LJ-STAND/Design-2017/Drawings & Pinouts/KS_T_3.5.jpg

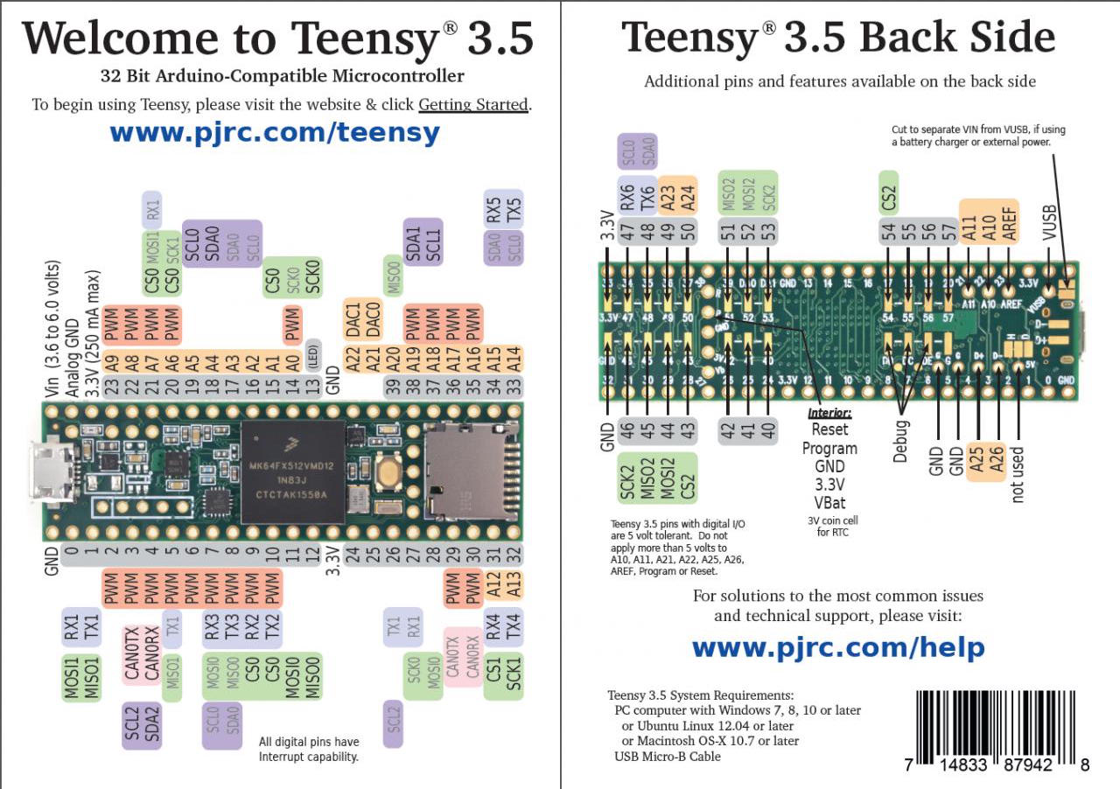
Drawings & Pinouts/KS_T_3.5.jpg
