LJ-STAND/Design-2017/Models/Pixy/Renderings/pixy_back.JPG

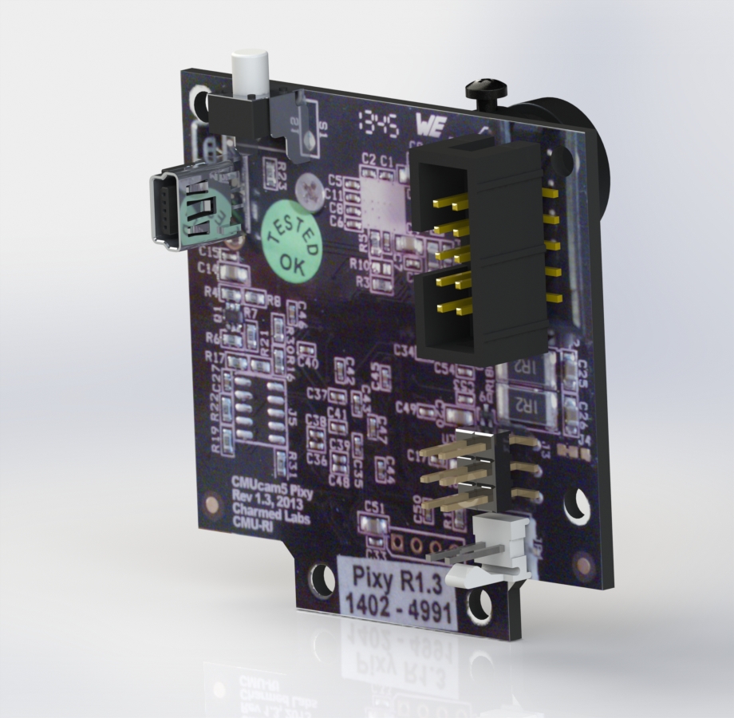
Models/Pixy/Renderings/pixy_back.JPG
