LJ-STAND/Design-2017/Drawings & Pinouts/Toshiba Motor Controller Circuit.PNG

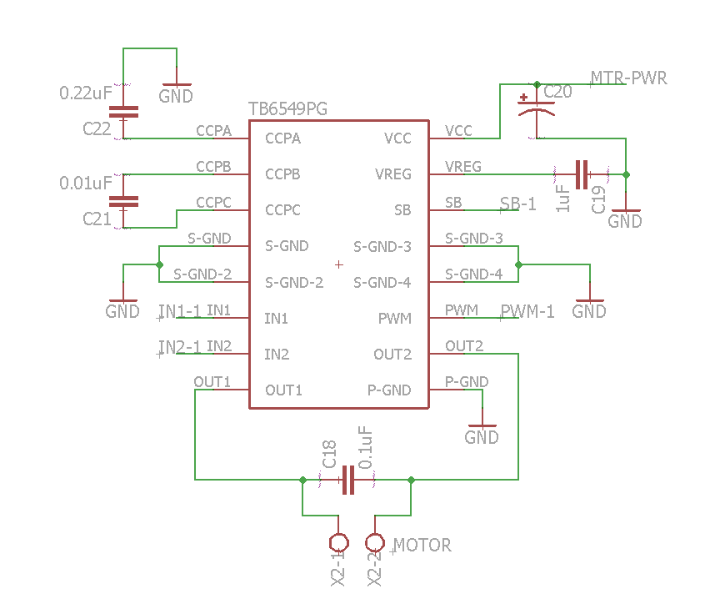
Drawings & Pinouts/Toshiba Motor Controller Circuit.PNG
