LJ-STAND/Design-2017/Models/Pixy/Renderings/pixy_front.JPG

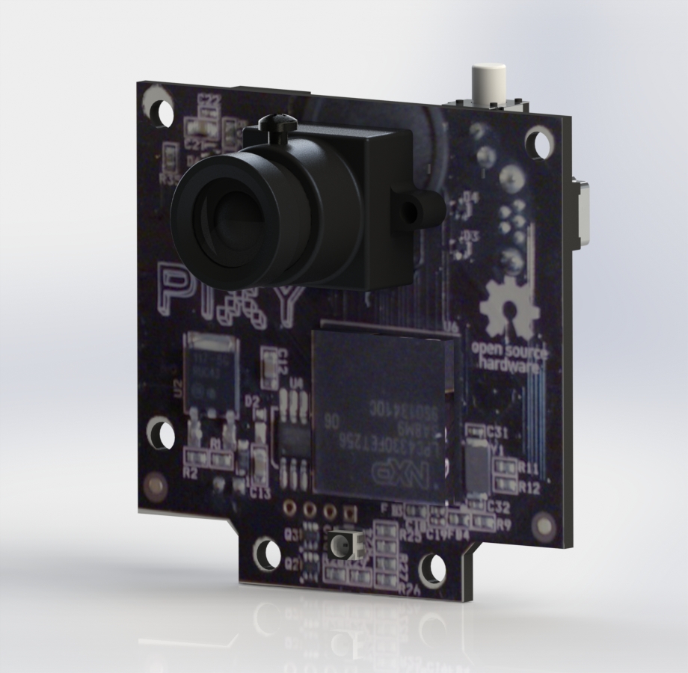
Models/Pixy/Renderings/pixy_front.JPG
