LJ-STAND/Design-2017/Robot top.png

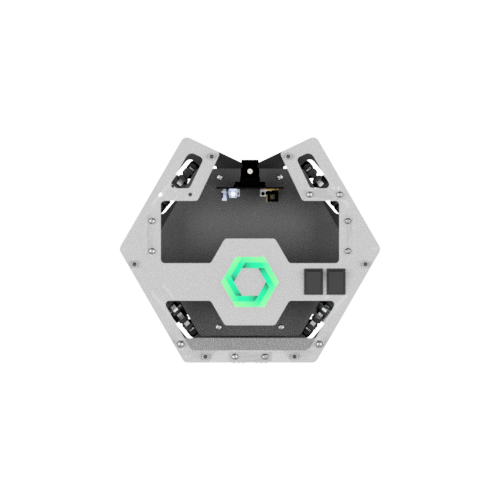
Robot top.png
