LJ-STAND/Design-2017/Models/Common/Imported Components/maxon_PN_0_1/maxon_PN_0_1.htm

Autodesk Inventor Translation Report | Friday, 11 November 2016 ( 8:32 PM)
Source File: | C:\Users\James Yelland\git\LJ-STAND\Design\Models\Common\maxon_PN_0_1.stp
Translator Type: | STEP | Sending System: | ACIS
Author: | maxon motor ag | Translation Time: | 00:00:02
Options
Import Type: | N/A
Entity Types to Import: | Solids, Surfaces, Wires, Points
Import into Repair Environment: | Yes
Import Assembly as Single Part: | No
Create Surfaces As: | Single Composite Feature
Check Parts during Load: | No
Auto Stitch: | No
Enable Advanced Healing: | N/A
+/- | Name | Inventor File | Status
[ ] | maxon_PN_0_1.iam | C:\Users\James Yelland\git\LJ-STAND\Design\Models\Common\Imported Components\maxon_PN_0_1\maxon_PN_0_1.iam | Successful
[ ] | maxon_PN_0_1.ipt | C:\Users\James Yelland\git\LJ-STAND\Design\Models\Common\Imported Components\maxon_PN_0_1\maxon_PN_0_1.ipt | Successful
[ ] | maxon_PN_0_2.ipt | C:\Users\James Yelland\git\LJ-STAND\Design\Models\Common\Imported Components\maxon_PN_0_1\maxon_PN_0_2.ipt | Successful
[ ] | maxon_PN_0_3.ipt | C:\Users\James Yelland\git\LJ-STAND\Design\Models\Common\Imported Components\maxon_PN_0_1\maxon_PN_0_3.ipt | Successful
[ ] | maxon_PN_0_3_1.ipt | C:\Users\James Yelland\git\LJ-STAND\Design\Models\Common\Imported Components\maxon_PN_0_1\maxon_PN_0_3_1.ipt | Successful
[ ] | maxon_PN_0_4.ipt | C:\Users\James Yelland\git\LJ-STAND\Design\Models\Common\Imported Components\maxon_PN_0_1\maxon_PN_0_4.ipt | Successful
[ ] | maxon_PN_0_5.ipt | C:\Users\James Yelland\git\LJ-STAND\Design\Models\Common\Imported Components\maxon_PN_0_1\maxon_PN_0_5.ipt | Successful
[ ] | maxon_PN_0_5_1.ipt | C:\Users\James Yelland\git\LJ-STAND\Design\Models\Common\Imported Components\maxon_PN_0_1\maxon_PN_0_5_1.ipt | Successful
[ ] | maxon_PN_0_5_2.ipt | C:\Users\James Yelland\git\LJ-STAND\Design\Models\Common\Imported Components\maxon_PN_0_1\maxon_PN_0_5_2.ipt | Successful
[ ] | maxon_PN_0_6.ipt | C:\Users\James Yelland\git\LJ-STAND\Design\Models\Common\Imported Components\maxon_PN_0_1\maxon_PN_0_6.ipt | Successful
[ ] | maxon_PN_0.ipt | C:\Users\James Yelland\git\LJ-STAND\Design\Models\Common\Imported Components\maxon_PN_0_1\maxon_PN_0.ipt | Successful
