LJ-STAND/Design-2017/Models/Pixy/pixy/Imported Components/Pixy(CMUcam5)/Pixy(CMUcam5).htm

Autodesk Inventor Translation Report | Friday, 11 November 2016 ( 9:08 PM)
Source File: | C:\Users\James Yelland\git\LJ-STAND\Design\Models\Pixy\pixy\Pixy(CMUcam5).STEP
Translator Type: | STEP | Sending System: | SolidWorks 2013
Author: |  | Translation Time: | 00:00:02
Options
Import Type: | N/A
Entity Types to Import: | Solids, Surfaces, Wires, Points
Import into Repair Environment: | Yes
Import Assembly as Single Part: | No
Create Surfaces As: | Single Composite Feature
Check Parts during Load: | No
Auto Stitch: | No
Enable Advanced Healing: | N/A
+/- | Name | Inventor File | Status
[ ] | Pixy(CMUcam5).iam | C:\Users\James Yelland\git\LJ-STAND\Design\Models\Pixy\pixy\Imported Components\Pixy(CMUcam5)\Pixy(CMUcam5).iam | Successful
[ ] | Pixy_board_rev1.3.ipt | C:\Users\James Yelland\git\LJ-STAND\Design\Models\Pixy\pixy\Imported Components\Pixy(CMUcam5)\Pixy_board_rev1.3.ipt | Successful
[ ] | header_2x5ways.ipt | C:\Users\James Yelland\git\LJ-STAND\Design\Models\Pixy\pixy\Imported Components\Pixy(CMUcam5)\header_2x5ways.ipt | Successful
[+] [-] | mini_usb_b_vertical_connector_D‚faut.ipt | C:\Users\James Yelland\git\LJ-STAND\Design\Models\Pixy\pixy\Imported Components\Pixy(CMUcam5)\mini_usb_b_vertical_connector_D‚faut.ipt | Warning
Severity | Entity Id | Message
Warning | 39828 | Some Surfaces have been simplified
[ ] | RGB_led_CMS_STD.ipt | C:\Users\James Yelland\git\LJ-STAND\Design\Models\Pixy\pixy\Imported Components\Pixy(CMUcam5)\RGB_led_CMS_STD.ipt | Successful
[ ] | switch-FSMRA6JH_D‚faut.ipt | C:\Users\James Yelland\git\LJ-STAND\Design\Models\Pixy\pixy\Imported Components\Pixy(CMUcam5)\switch-FSMRA6JH_D‚faut.ipt | Successful
[ ] | M12_lens_holder_D‚faut.ipt | C:\Users\James Yelland\git\LJ-STAND\Design\Models\Pixy\pixy\Imported Components\Pixy(CMUcam5)\M12_lens_holder_D‚faut.ipt | Successful
[ ] | header3x2_D‚faut.ipt | C:\Users\James Yelland\git\LJ-STAND\Design\Models\Pixy\pixy\Imported Components\Pixy(CMUcam5)\header3x2_D‚faut.ipt | Successful
[ ] | header_MTA-100_2pins_D‚faut.ipt | C:\Users\James Yelland\git\LJ-STAND\Design\Models\Pixy\pixy\Imported Components\Pixy(CMUcam5)\header_MTA-100_2pins_D‚faut.ipt | Successful
[ ] | pixy_lens_D‚faut.ipt | C:\Users\James Yelland\git\LJ-STAND\Design\Models\Pixy\pixy\Imported Components\Pixy(CMUcam5)\pixy_lens_D‚faut.ipt | Successful
[ ] | pan head cross recess screw_iso_ISO 7045 - M2 x 4 - Z --- 4C.ipt | C:\Users\James Yelland\git\LJ-STAND\Design\Models\Pixy\pixy\Imported Components\Pixy(CMUcam5)\pan head cross recess screw_iso_ISO 7045 - M2 x 4 - Z --- 4C.ipt | Successful
