LJ-STAND/Design-2017/PCBs/Main.dxf

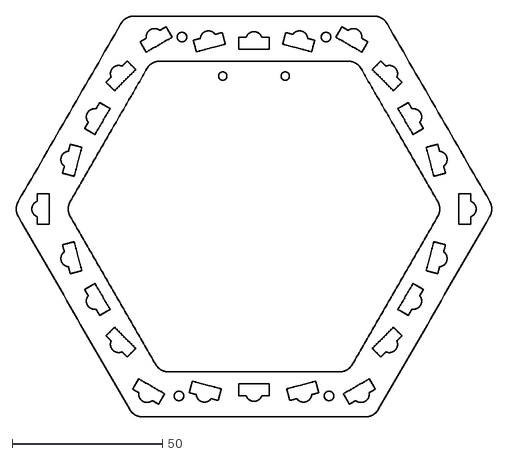
[picture p6: CAD file, 2016-11-10]
PCBs/Main.dxf
158.5 x 133.6
