LJ-STAND/Design-2017/3D Printing/Ball Capture Zone Cover.stl

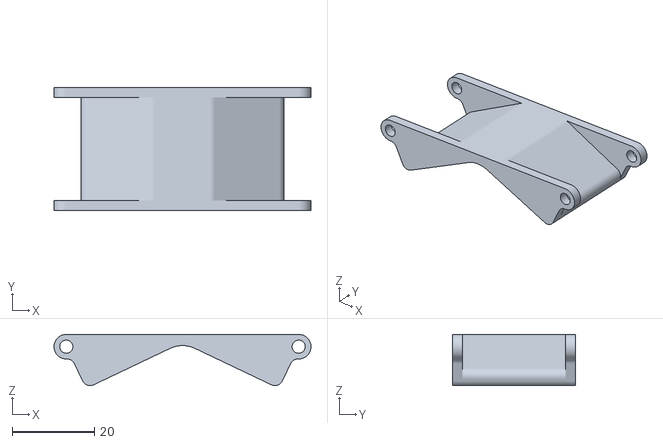
[picture p7: CAD file, 2017-07-10]
3D Printing/Ball Capture Zone Cover.stl
62.5 x 30.0 x 12.5
