LJ-STAND/Design-2017/Models/Common/maxon_PN_0_1.stp

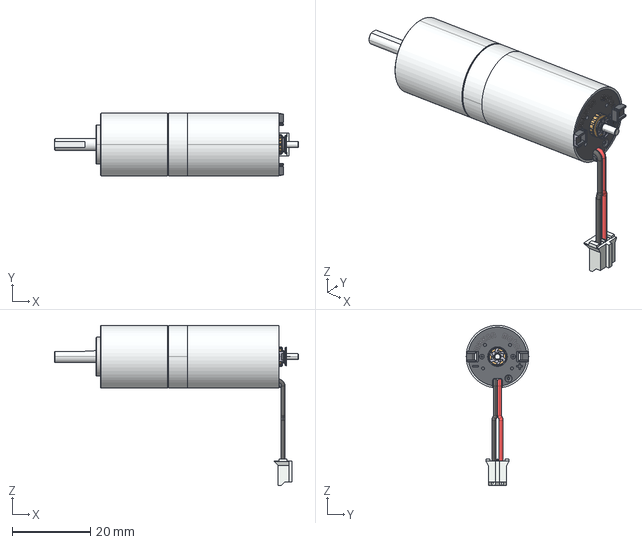
[picture p8: CAD file, 2016-10-30]
Models/Common/maxon_PN_0_1.stp
62.4 x 16.0 x 41.0 mm
