LJ-STAND/Design-2017/Models/Pixy/pixy/M12_lens_holder.SLDPRT

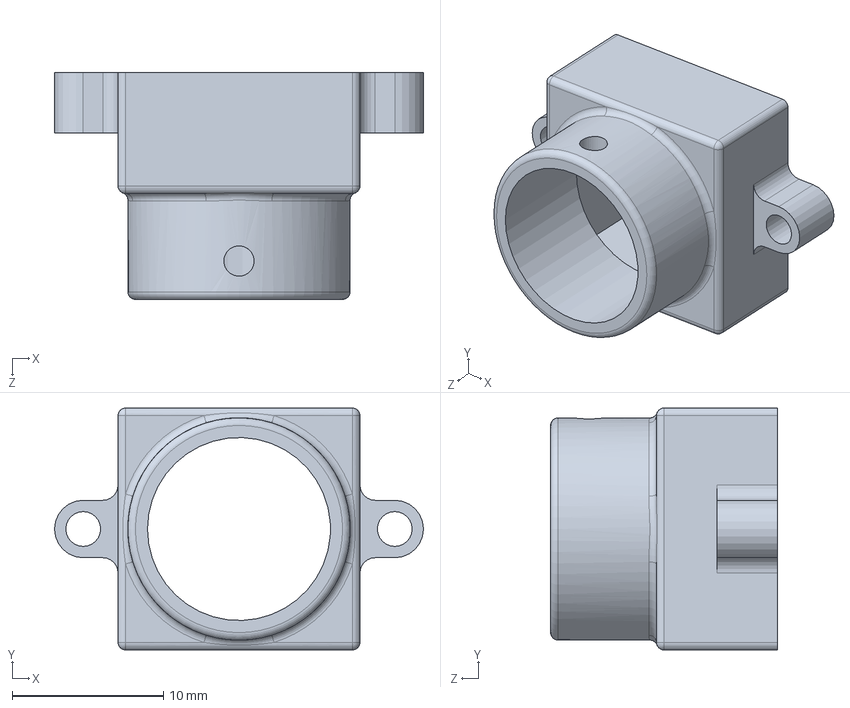
[picture p9: CAD file, 2016-09-21]
Models/Pixy/pixy/M12_lens_holder.SLDPRT
24.4 x 16.0 x 15.0 mm
