LJ-STAND/Design-2017/3D Printing/TSOP Cover Ring.stl

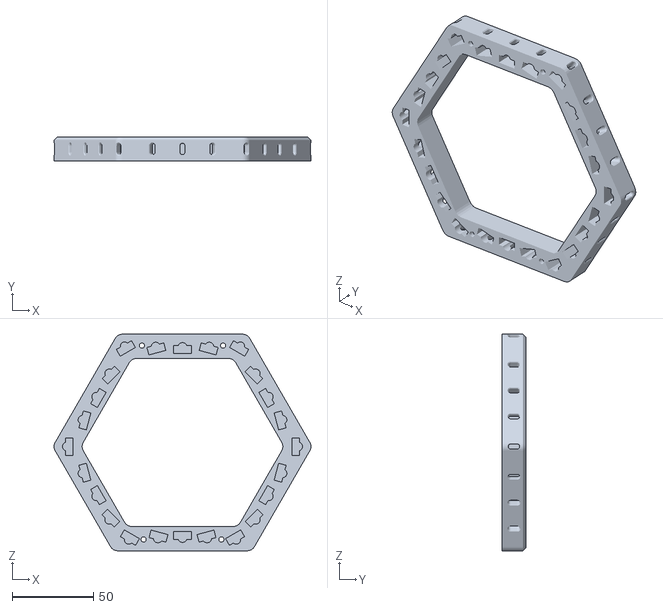
[picture p10: CAD file, 2017-03-27]
3D Printing/TSOP Cover Ring.stl
158.5 x 15.0 x 133.6
