LJ-STAND/Design-2017/Models/Pixy/pixy/RGB_led_CMS.SLDPRT

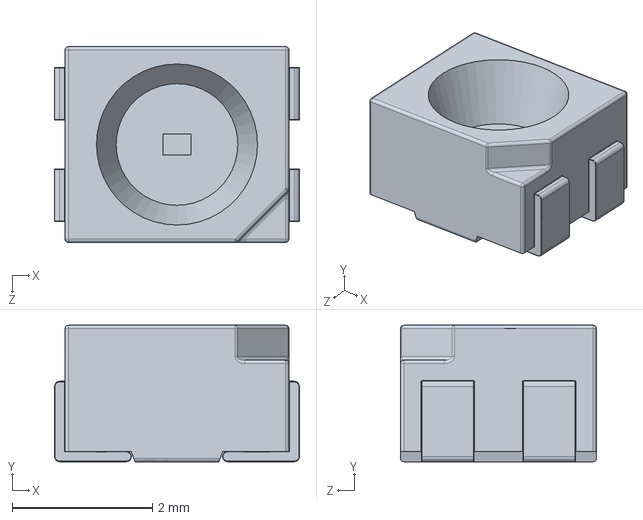
[picture p11: CAD file, 2016-09-21]
Models/Pixy/pixy/RGB_led_CMS.SLDPRT
3.50 x 1.95 x 2.80 mm
