LJ-STAND/Design-2017/PCBs/Kicker.dxf

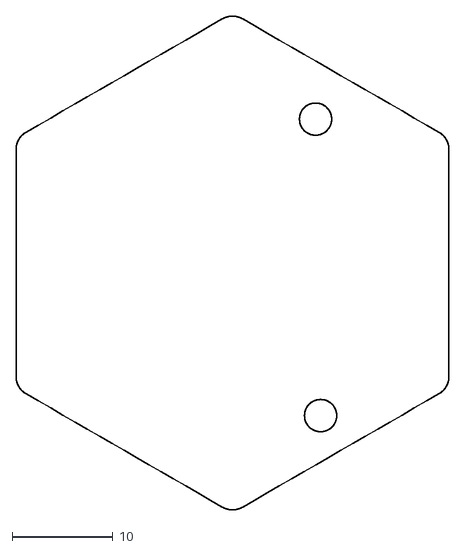
[picture p12: CAD file, 2017-03-21]
PCBs/Kicker.dxf
43.0 x 49.0
