LJ-STAND/Design-2017/3D Printing/Sonar Mount.stl

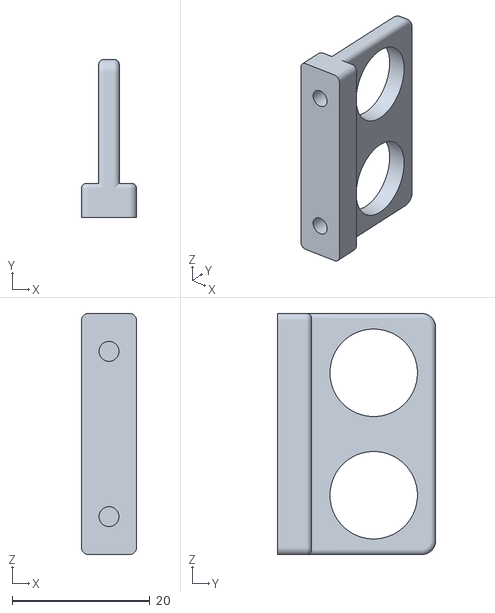
[picture p13: CAD file, 2016-11-30]
3D Printing/Sonar Mount.stl
8.00 x 23.0 x 35.0
