LJ-STAND/Design-2017/Models/Pixy/pixy/pixy_lens.SLDPRT

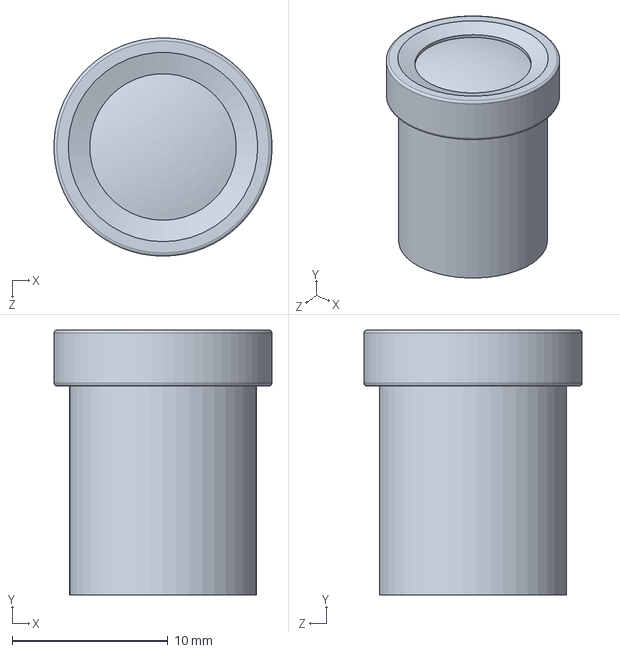
[picture p14: CAD file, 2016-09-21]
Models/Pixy/pixy/pixy_lens.SLDPRT
14.0 x 17.0 x 14.0 mm
