LJ-STAND/Design-2017/PCBs/Light.dxf

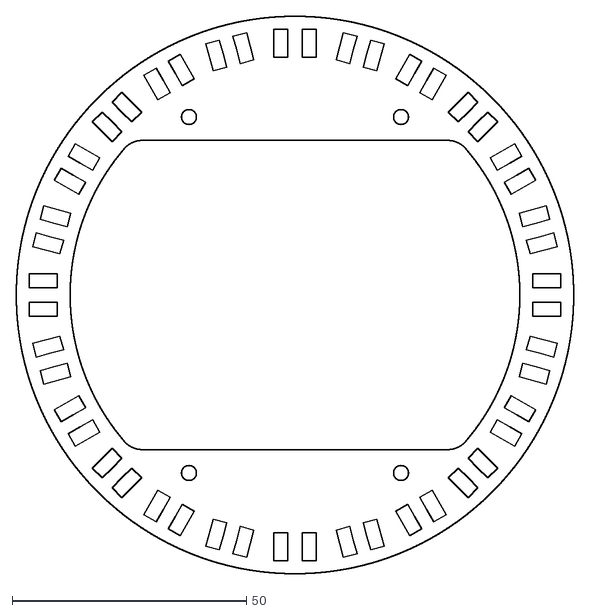
[picture p15: CAD file, 2016-11-10]
PCBs/Light.dxf
119.0 x 119.0
