LJ-STAND/Design-2017/Plates/Wheel/Roller.dxf

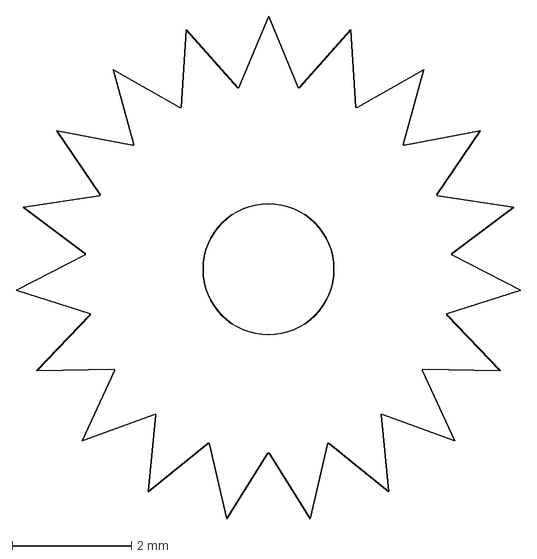
[picture p16: CAD file, 2016-12-01]
Plates/Wheel/Roller.dxf
8.47 x 8.44 mm
