LJ-STAND/Design-2017/Models/Pixy/pixy/header3x2.SLDPRT

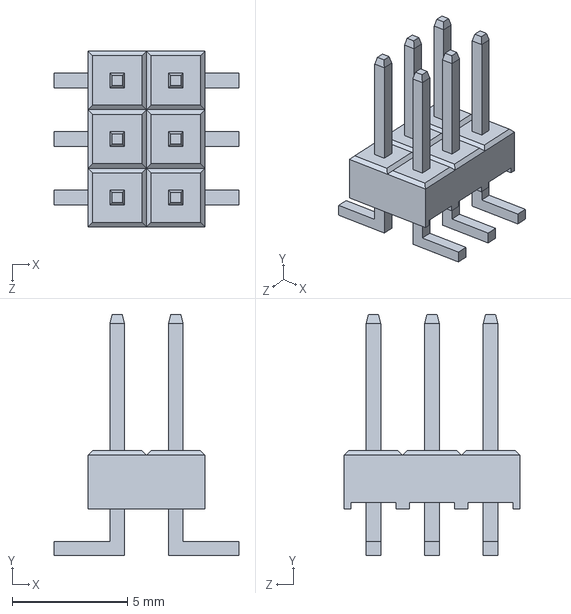
[picture p17: CAD file, 2016-09-21]
Models/Pixy/pixy/header3x2.SLDPRT
8.00 x 10.4 x 7.62 mm
