LJ-STAND/Design-2017/Models/Pixy/pixy/Pixy_board.SLDPRT

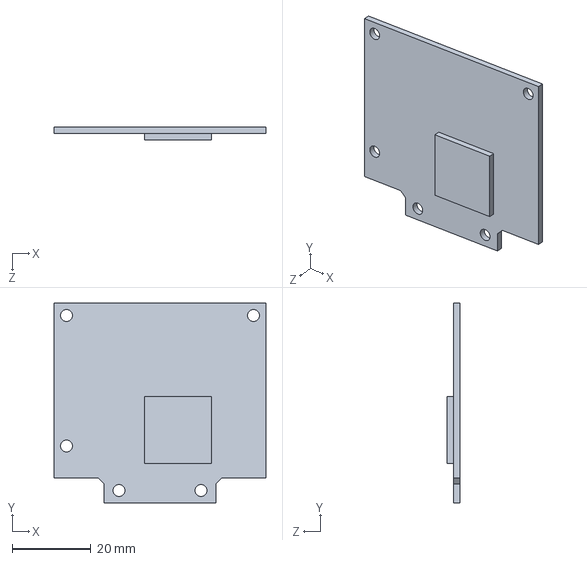
[picture p18: CAD file, 2016-09-21]
Models/Pixy/pixy/Pixy_board.SLDPRT
53.8 x 50.8 x 3.20 mm
