LJ-STAND/Design-2017/Models/Pixy/pixy/header_2x5ways.SLDPRT

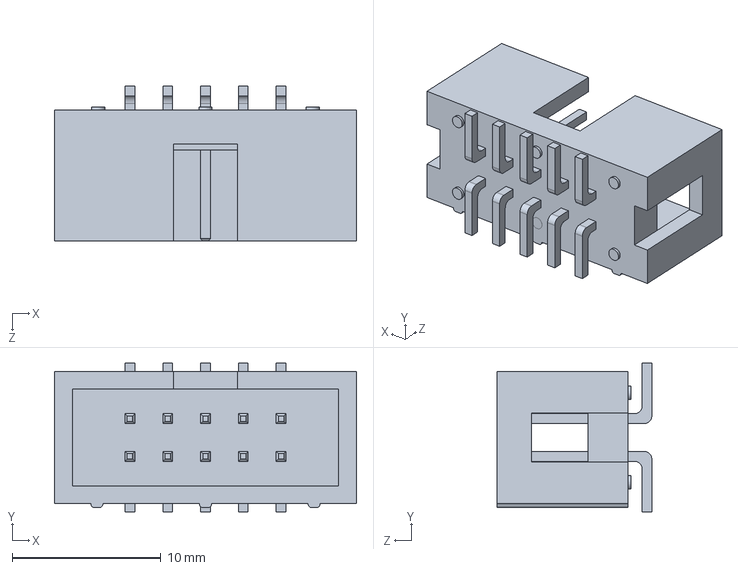
[picture p19: CAD file, 2016-09-21]
Models/Pixy/pixy/header_2x5ways.SLDPRT
20.3 x 10.0 x 10.4 mm
