LJ-STAND/Design-2017/Models/Pixy/pixy/switch-FSMRA6JH.SLDPRT

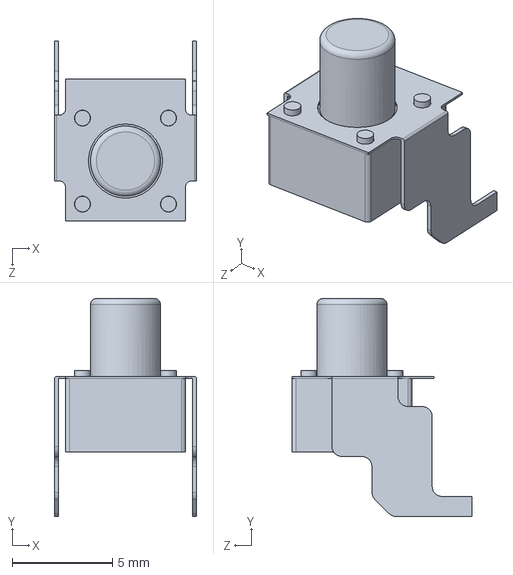
[picture p20: CAD file, 2016-09-21]
Models/Pixy/pixy/switch-FSMRA6JH.SLDPRT
7.11 x 10.9 x 8.99 mm
