LJ-STAND/Design-2017/Models/Pixy/pixy/mini_usb_b_vertical_connector.SLDPRT

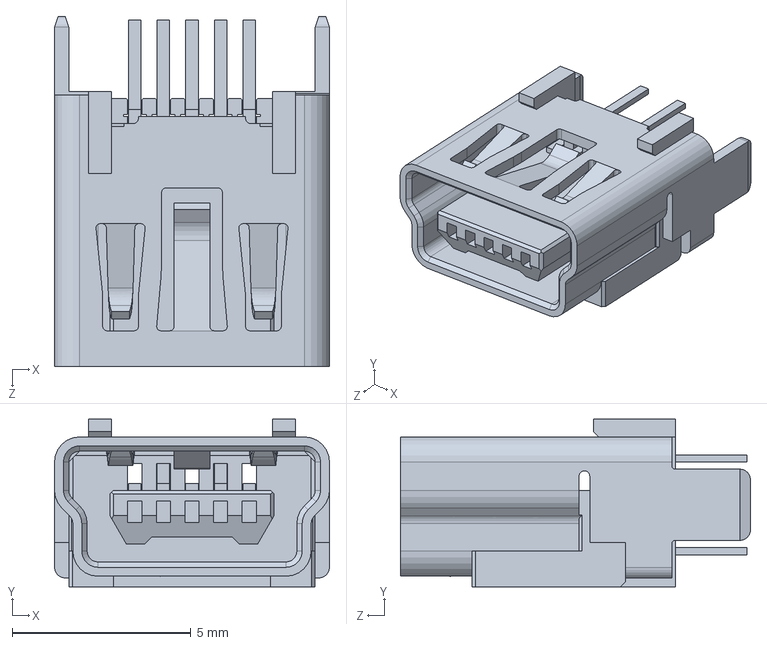
[picture p21: CAD file, 2016-09-21]
Models/Pixy/pixy/mini_usb_b_vertical_connector.SLDPRT
7.70 x 4.70 x 9.80 mm
