LJ-STAND/Design-2017/Models/Pixy/pixy/header_MTA-100_2pins.SLDPRT

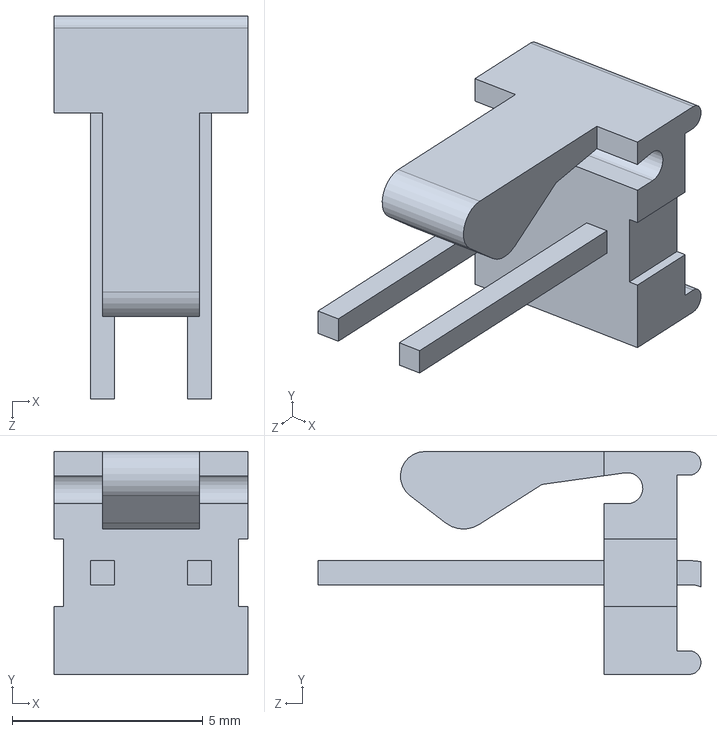
[picture p22: CAD file, 2016-09-21]
Models/Pixy/pixy/header_MTA-100_2pins.SLDPRT
5.08 x 5.84 x 10.0 mm
