LJ-STAND/Design-2017/Models/Pixy/pixy/Pixy(CMUcam5).STEP

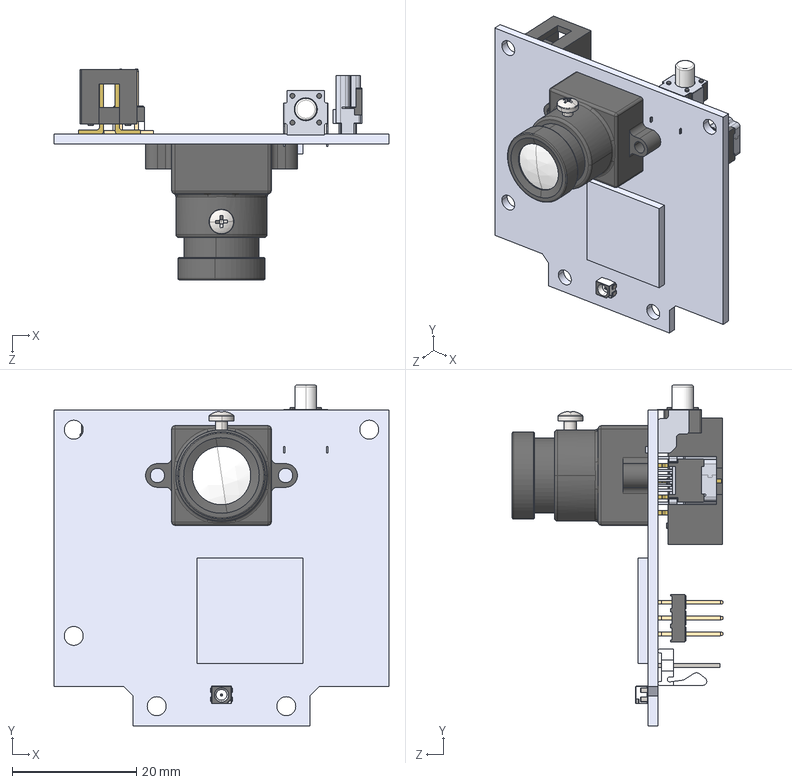
[picture p23: CAD file, 2016-09-21]
Models/Pixy/pixy/Pixy(CMUcam5).STEP
53.8 x 54.8 x 33.8 mm
Pixy_board_rev1.3
header_2x5ways
mini_usb_b_vertical_connector_DＧaut
RGB_led_CMS_STD
switch-FSMRA6JH_DＧaut
M12_lens_holder_DＧaut
header3x2_DＧaut
header_MTA-100_2pins_DＧaut
pixy_lens_DＧaut
pan head cross recess screw_iso_ISO 7045 - M2 x 4 - Z --- 4C
