LJ-STAND/Design-2017/(list of files, cad)

Other CAD files:
PCBs/Main2004.dwg
PCBs/Kicker2004.dwg
Plates/Tall Handle.dwg
Plates/Wheel/Plate 1.dwg
Plates/Bottom Plate.dwg
Plates/Wheel/Plate 2.dwg
Plates/LDR Mount Plate.dwg
Plates/Middle Plate.dwg
Plates/Wheel/Plate 3.dwg
PCBs/Light2004.dwg
Plates/Top Plate.dwg
Plates/Wheel/Rolller.dwg
Plates/Laser Mount Plate.dwg
Plates/Light Sensor Cover.dwg
Plates/Motor Mount.dwg
Plates/Handle.dwg
Models/Bottom Plate.ipt
Models/Common/Ball.ipt
Models/Common/Battery.ipt
Models/Common/Gear.ipt
Models/Common/Imported Components/maxon_PN_0_1/OldVersions/maxon_PN_0.0002.ipt
Models/Common/Imported Components/maxon_PN_0_1/OldVersions/maxon_PN_0_1.0002.ipt
Models/Common/Imported Components/maxon_PN_0_1/OldVersions/maxon_PN_0_1.0003.iam
Models/Common/Imported Components/maxon_PN_0_1/OldVersions/maxon_PN_0_2.0002.ipt
Models/Common/Imported Components/maxon_PN_0_1/OldVersions/maxon_PN_0_3.0002.ipt
Models/Common/Imported Components/maxon_PN_0_1/OldVersions/maxon_PN_0_3_1.0002.ipt
Models/Common/Imported Components/maxon_PN_0_1/OldVersions/maxon_PN_0_4.0002.ipt
Models/Common/Imported Components/maxon_PN_0_1/OldVersions/maxon_PN_0_5.0002.ipt
Models/Common/Imported Components/maxon_PN_0_1/OldVersions/maxon_PN_0_5_1.0002.ipt
Models/Common/Imported Components/maxon_PN_0_1/OldVersions/maxon_PN_0_5_2.0002.ipt
Models/Common/Imported Components/maxon_PN_0_1/OldVersions/maxon_PN_0_6.0002.ipt
Models/Common/Imported Components/maxon_PN_0_1/maxon_PN_0.ipt
Models/Common/Imported Components/maxon_PN_0_1/maxon_PN_0_1.iam
Models/Common/Imported Components/maxon_PN_0_1/maxon_PN_0_1.ipt
Models/Common/Imported Components/maxon_PN_0_1/maxon_PN_0_2.ipt
Models/Common/Imported Components/maxon_PN_0_1/maxon_PN_0_3.ipt
Models/Common/Imported Components/maxon_PN_0_1/maxon_PN_0_3_1.ipt
Models/Common/Imported Components/maxon_PN_0_1/maxon_PN_0_4.ipt
Models/Common/Imported Components/maxon_PN_0_1/maxon_PN_0_5.ipt
Models/Common/Imported Components/maxon_PN_0_1/maxon_PN_0_5_1.ipt
Models/Common/Imported Components/maxon_PN_0_1/maxon_PN_0_5_2.ipt
Models/Common/Imported Components/maxon_PN_0_1/maxon_PN_0_6.ipt
Models/Common/Laser Diode.ipt
Models/Common/OldVersions/Battery.0005.ipt
Models/Common/OldVersions/Gear.0002.ipt
Models/Common/OldVersions/Motor.0013.ipt
Models/Common/OldVersions/Pixy angle bracket.0001.ipt
Models/Common/OldVersions/Rocker switch.0014.ipt
Models/Common/OldVersions/Sonar.0001.ipt
Models/Common/OldVersions/Standoff 10.0016.ipt
Models/Common/OldVersions/Standoff 20.0016.ipt
Models/Common/OldVersions/Standoff 30.0014.ipt
Models/Common/OldVersions/Standoff 50.0020.ipt
Models/Common/OldVersions/Switch.0010.ipt
Models/Common/OldVersions/Toggle switch.0005.ipt
Models/Common/OldVersions/Wheel.0016.ipt
Models/Common/OldVersions/XBee mount.0001.ipt
Models/Common/Pixy angle bracket.ipt
Models/Common/Rocker switch.ipt
Models/Common/Sonar.ipt
Models/Common/Wheel.ipt
Models/Common/XBee mount.ipt
Models/Common/micro-metal-gearmotor-carbon.ipt
Models/Fasteners/M2x4 Screw.ipt
Models/Fasteners/M3 Hex Nut.ipt
Models/Fasteners/M3x10 Screw.ipt
Models/Fasteners/M3x20 Screw.ipt
Models/Fasteners/M3x6 Screw.ipt
Models/Fasteners/OldVersions/M2x4 Screw.0007.ipt
Models/Fasteners/OldVersions/M3 Hex Nut.0002.ipt
Models/Fasteners/OldVersions/M3x10 Screw.0006.ipt
Models/Fasteners/OldVersions/M3x20 Screw.0007.ipt
Models/Fasteners/OldVersions/M3x6 Screw.0007.ipt
Models/Fasteners/OldVersions/Standoff 10 M-F.0020.ipt
Models/Fasteners/OldVersions/Standoff 20 F-F.0021.ipt
Models/Fasteners/OldVersions/Standoff 20 M-F.0019.ipt
Models/Fasteners/OldVersions/Standoff 20 M-F.0020.ipt
Models/Fasteners/OldVersions/Standoff 25 F-F.0023.ipt
Models/Fasteners/OldVersions/Standoff 30 F-F.0019.ipt
Models/Fasteners/OldVersions/Standoff 30 M-F.0017.ipt
Models/Fasteners/OldVersions/Standoff 50 M-F.0019.ipt
Models/Fasteners/OldVersions/Standoff 50 M-F.0020.ipt
Models/Fasteners/OldVersions/Standoff 50 M-F.0021.ipt
Models/Fasteners/OldVersions/Standoff 65 M-F.0023.ipt
Models/Fasteners/OldVersions/Standoff 80 F-F.0024.ipt
Models/Fasteners/Standoff 10 M-F.ipt
Models/Fasteners/Standoff 20 F-F.ipt
Models/Fasteners/Standoff 25 F-F.ipt
Models/Fasteners/Standoff 30 F-F.ipt
Models/Fasteners/Standoff 30 M-F.ipt
Models/Fasteners/Standoff 50 M-F.ipt
Models/Fasteners/Standoff 65 M-F.ipt
Models/Fasteners/Standoff 80 F-F.ipt
Models/Imported Components/Pixy(CMUcam5)/M12_lens_holder_Dfaut.ipt
Models/Imported Components/Pixy(CMUcam5)/OldVersions/Pixy(CMUcam5).0002.iam
Models/Imported Components/Pixy(CMUcam5)/Pixy(CMUcam5).iam
Models/Imported Components/Pixy(CMUcam5)/Pixy_board_rev1.3.ipt
Models/Imported Components/Pixy(CMUcam5)/RGB_led_CMS_STD.ipt
Models/Imported Components/Pixy(CMUcam5)/header3x2_Dfaut.ipt
Models/Imported Components/Pixy(CMUcam5)/header_2x5ways.ipt
Models/Imported Components/Pixy(CMUcam5)/header_MTA-100_2pins_Dfaut.ipt
Models/Imported Components/Pixy(CMUcam5)/mini_usb_b_vertical_connector_Dfaut.ipt
Models/Imported Components/Pixy(CMUcam5)/pan head cross recess screw_iso_ISO 7045 - M2 x 4 - Z --- 4C.ipt
Models/Imported Components/Pixy(CMUcam5)/pixy_lens_Dfaut.ipt
Models/Imported Components/Pixy(CMUcam5)/switch-FSMRA6JH_Dfaut.ipt
Models/OldVersions/Bottom Plate.0032.ipt
Models/OldVersions/Front Support.0007.ipt
Models/OldVersions/Handle Ring.0002.ipt
Models/OldVersions/Kicker Plate.0001.ipt
Models/OldVersions/Middle Plate.0038.ipt
Models/OldVersions/Motor Mount.0003.ipt
Models/OldVersions/Motor.0006.ipt
Models/OldVersions/PCB.0013.ipt
Models/OldVersions/Robot.0078.iam
Models/OldVersions/Solenoid Mount.0004.ipt
Models/OldVersions/Solenoid Mount.0014.ipt
Models/OldVersions/Solenoid.0004.ipt
Models/OldVersions/Standoff 10.0014.ipt
Models/OldVersions/Standoff 30.0013.ipt
Models/OldVersions/Standoff 35.0011.ipt
Models/OldVersions/Standoff 40.0014.ipt
Models/OldVersions/Standoff 45.0009.ipt
Models/OldVersions/Standoff 50.0016.ipt
Models/OldVersions/Standoff 93.0010.ipt
Models/OldVersions/TSOP Ring.0008.ipt
Models/OldVersions/TSOP Ring.0014.ipt
Models/OldVersions/Top Plate.0009.ipt
Models/OldVersions/Wheel.0015.ipt
Models/PCB.ipt
Models/Pixy/pixy/Imported Components/Pixy(CMUcam5)/M12_lens_holder_D‚faut.ipt
Models/Pixy/pixy/Imported Components/Pixy(CMUcam5)/OldVersions/M12_lens_holder_D‚faut.0002.ipt
Models/Pixy/pixy/Imported Components/Pixy(CMUcam5)/OldVersions/Pixy(CMUcam5).0003.iam
Models/Pixy/pixy/Imported Components/Pixy(CMUcam5)/OldVersions/Pixy_board_rev1.3.0002.ipt
Models/Pixy/pixy/Imported Components/Pixy(CMUcam5)/OldVersions/RGB_led_CMS_STD.0002.ipt
Models/Pixy/pixy/Imported Components/Pixy(CMUcam5)/OldVersions/header3x2_D‚faut.0002.ipt
Models/Pixy/pixy/Imported Components/Pixy(CMUcam5)/OldVersions/header_2x5ways.0002.ipt
Models/Pixy/pixy/Imported Components/Pixy(CMUcam5)/OldVersions/header_MTA-100_2pins_D‚faut.0002.ipt
Models/Pixy/pixy/Imported Components/Pixy(CMUcam5)/OldVersions/mini_usb_b_vertical_connector_D‚faut.0002.ipt
Models/Pixy/pixy/Imported Components/Pixy(CMUcam5)/OldVersions/pan head cross recess screw_iso_ISO 7045 - M2 x 4 - Z --- 4C.0002.ipt
Models/Pixy/pixy/Imported Components/Pixy(CMUcam5)/OldVersions/pixy_lens_D‚faut.0002.ipt
Models/Pixy/pixy/Imported Components/Pixy(CMUcam5)/OldVersions/switch-FSMRA6JH_D‚faut.0002.ipt
Models/Pixy/pixy/Imported Components/Pixy(CMUcam5)/Pixy(CMUcam5).iam
Models/Pixy/pixy/Imported Components/Pixy(CMUcam5)/Pixy_board_rev1.3.ipt
Models/Pixy/pixy/Imported Components/Pixy(CMUcam5)/RGB_led_CMS_STD.ipt
Models/Pixy/pixy/Imported Components/Pixy(CMUcam5)/header3x2_D‚faut.ipt
Models/Pixy/pixy/Imported Components/Pixy(CMUcam5)/header_2x5ways.ipt
Models/Pixy/pixy/Imported Components/Pixy(CMUcam5)/header_MTA-100_2pins_D‚faut.ipt
Models/Pixy/pixy/Imported Components/Pixy(CMUcam5)/mini_usb_b_vertical_connector_D‚faut.ipt
Models/Pixy/pixy/Imported Components/Pixy(CMUcam5)/pan head cross recess screw_iso_ISO 7045 - M2 x 4 - Z --- 4C.ipt
Models/Pixy/pixy/Imported Components/Pixy(CMUcam5)/pixy_lens_D‚faut.ipt
Models/Pixy/pixy/Imported Components/Pixy(CMUcam5)/switch-FSMRA6JH_D‚faut.ipt
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
