LJ-STAND/Design-2017/Laser Cutting/Tall Handle.pdf

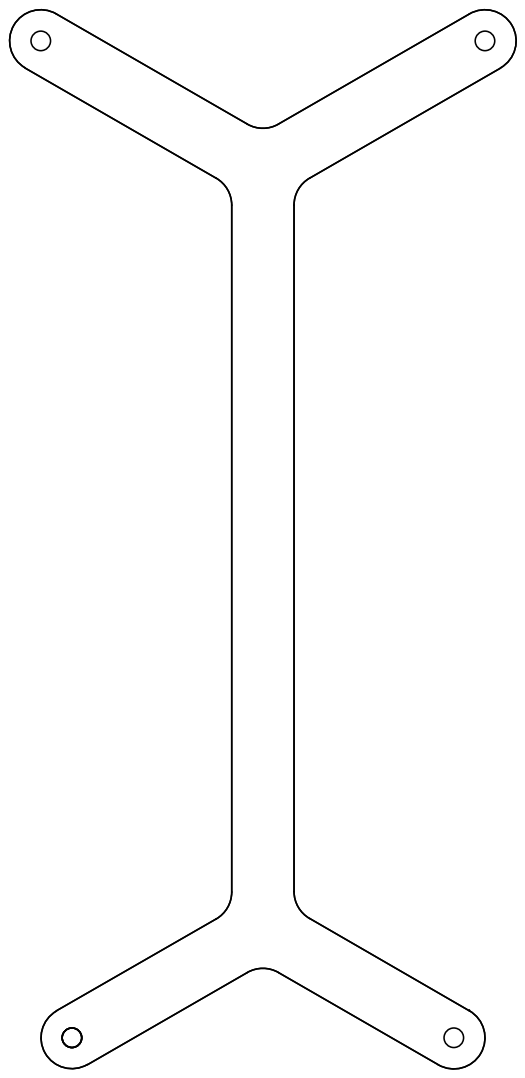
[picture p24: page 1]
