LJ-STAND/Design-2017/Laser Cutting/Bottom Plate.pdf

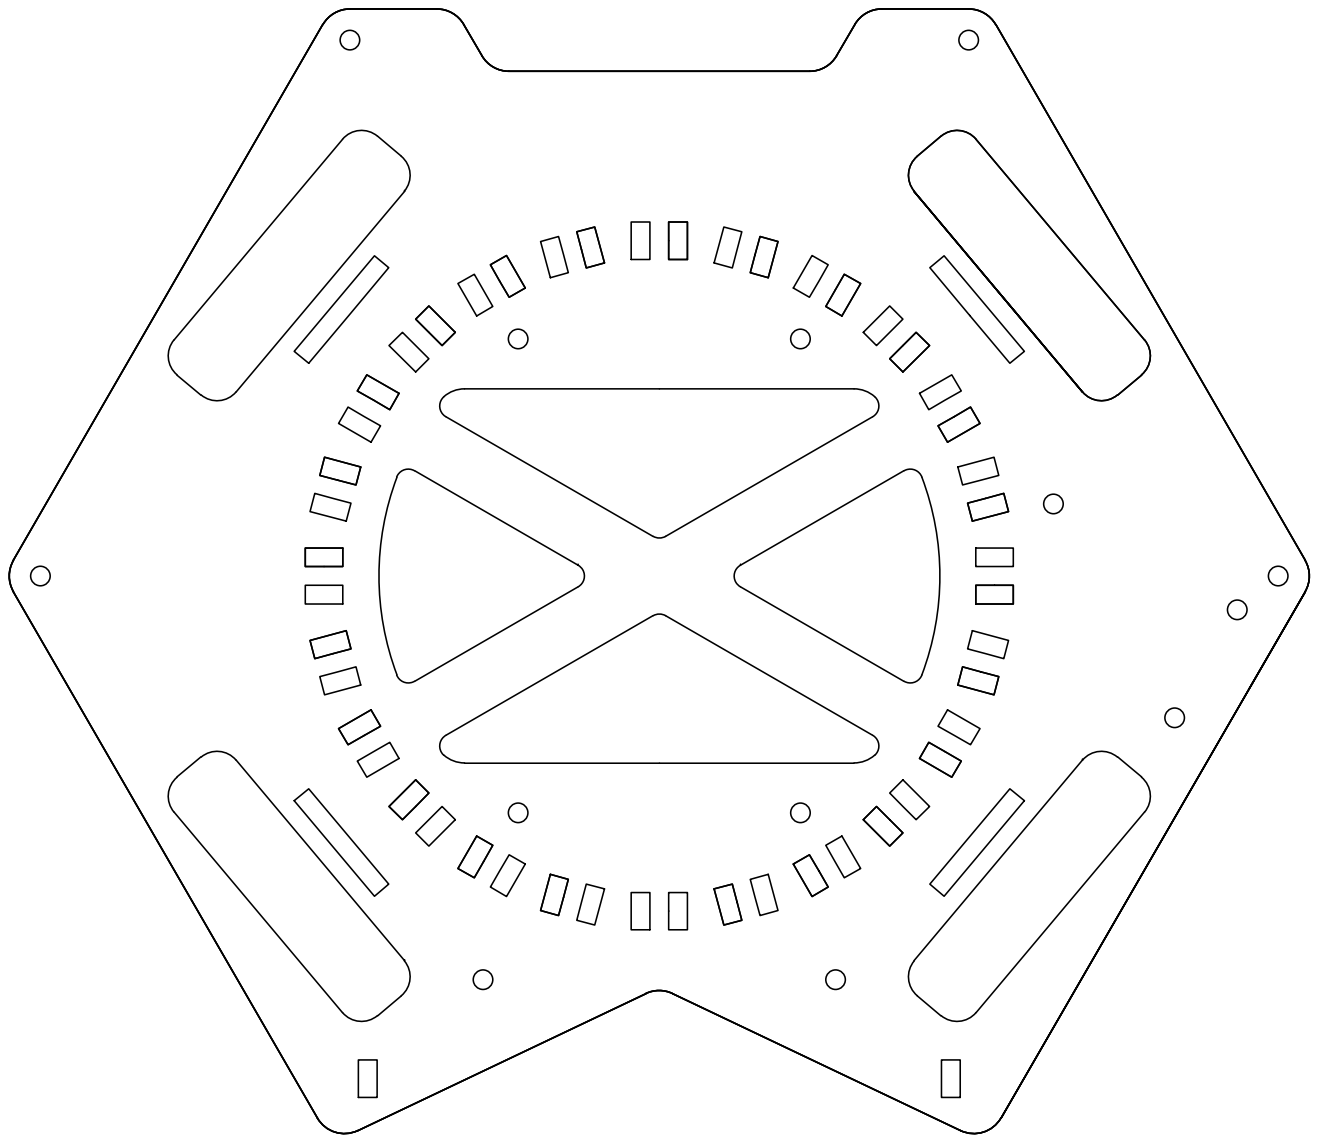
[picture p25: page 1]
