LJ-STAND/Design-2017/Laser Cutting/LDR Mount Plate.pdf

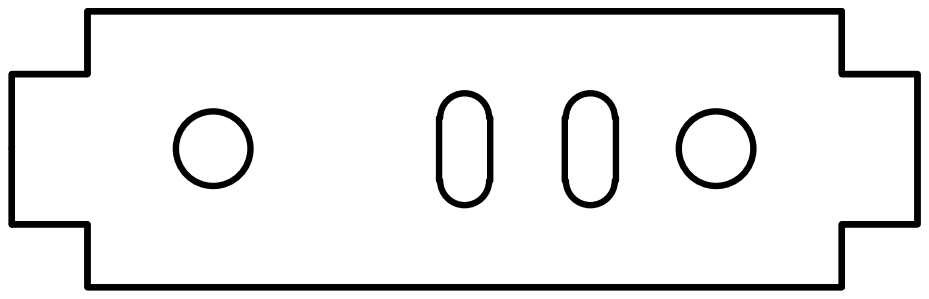
[picture p26: page 1]
