LJ-STAND/Design-2017/Laser Cutting/Middle Plate.pdf

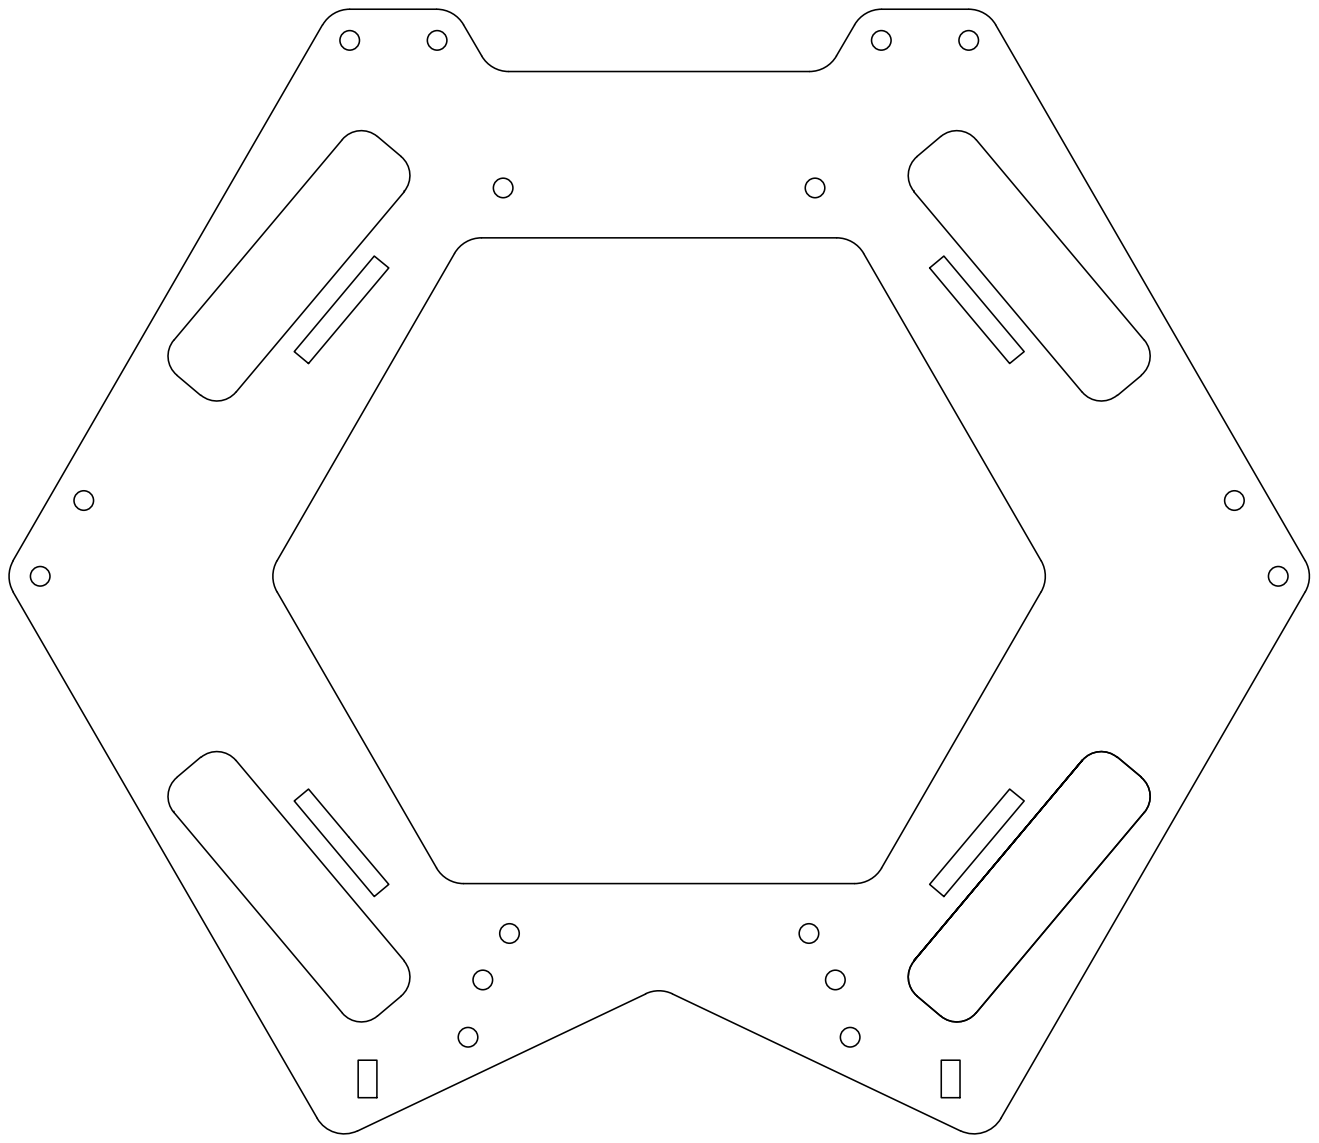
[picture p27: page 1]
