LJ-STAND/Design-2017/Laser Cutting/Top Plate.pdf

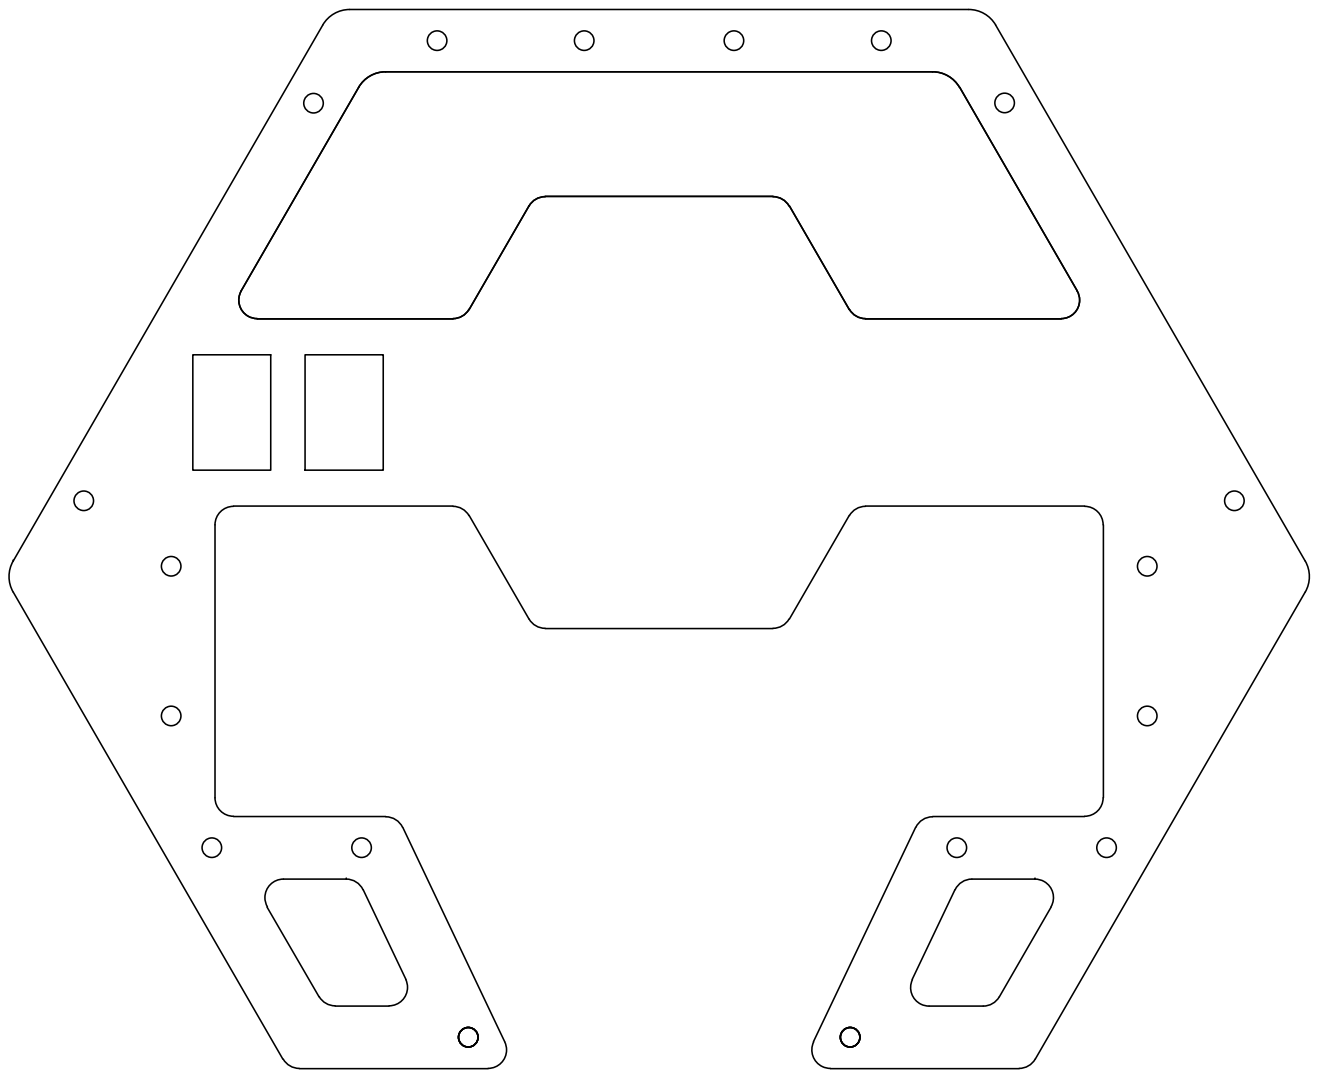
[picture p28: page 1]
