LJ-STAND/Design-2017/Laser Cutting/Laser Mount Plate.pdf

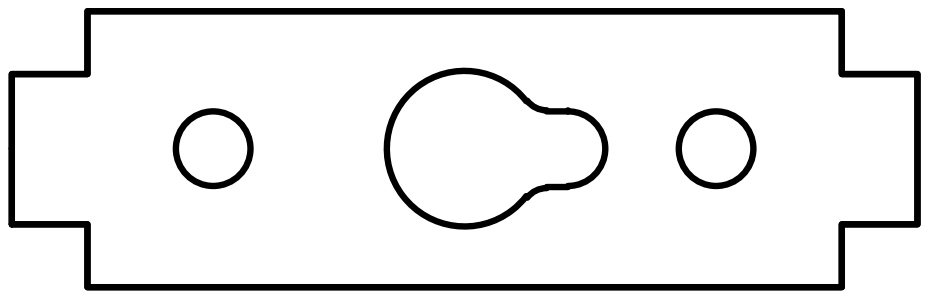
[picture p29: page 1]
