LJ-STAND/Design-2017/Laser Cutting/Light Gate Compression Plate.pdf

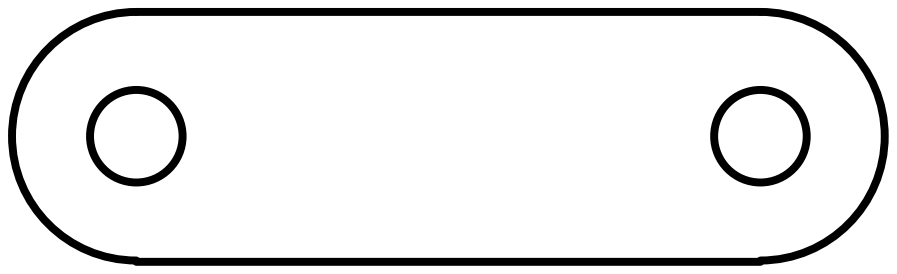
[picture p30: page 1]
