LJ-STAND/Design-2017/Laser Cutting/Light Sensor Cover.pdf

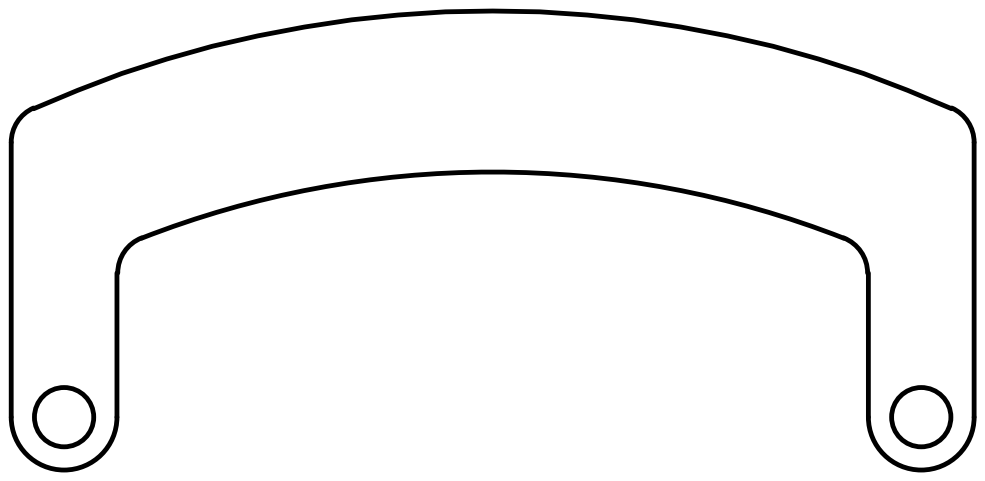
[picture p31: page 1]
