LJ-STAND/Design-2017/Laser Cutting/Motor Mount.pdf

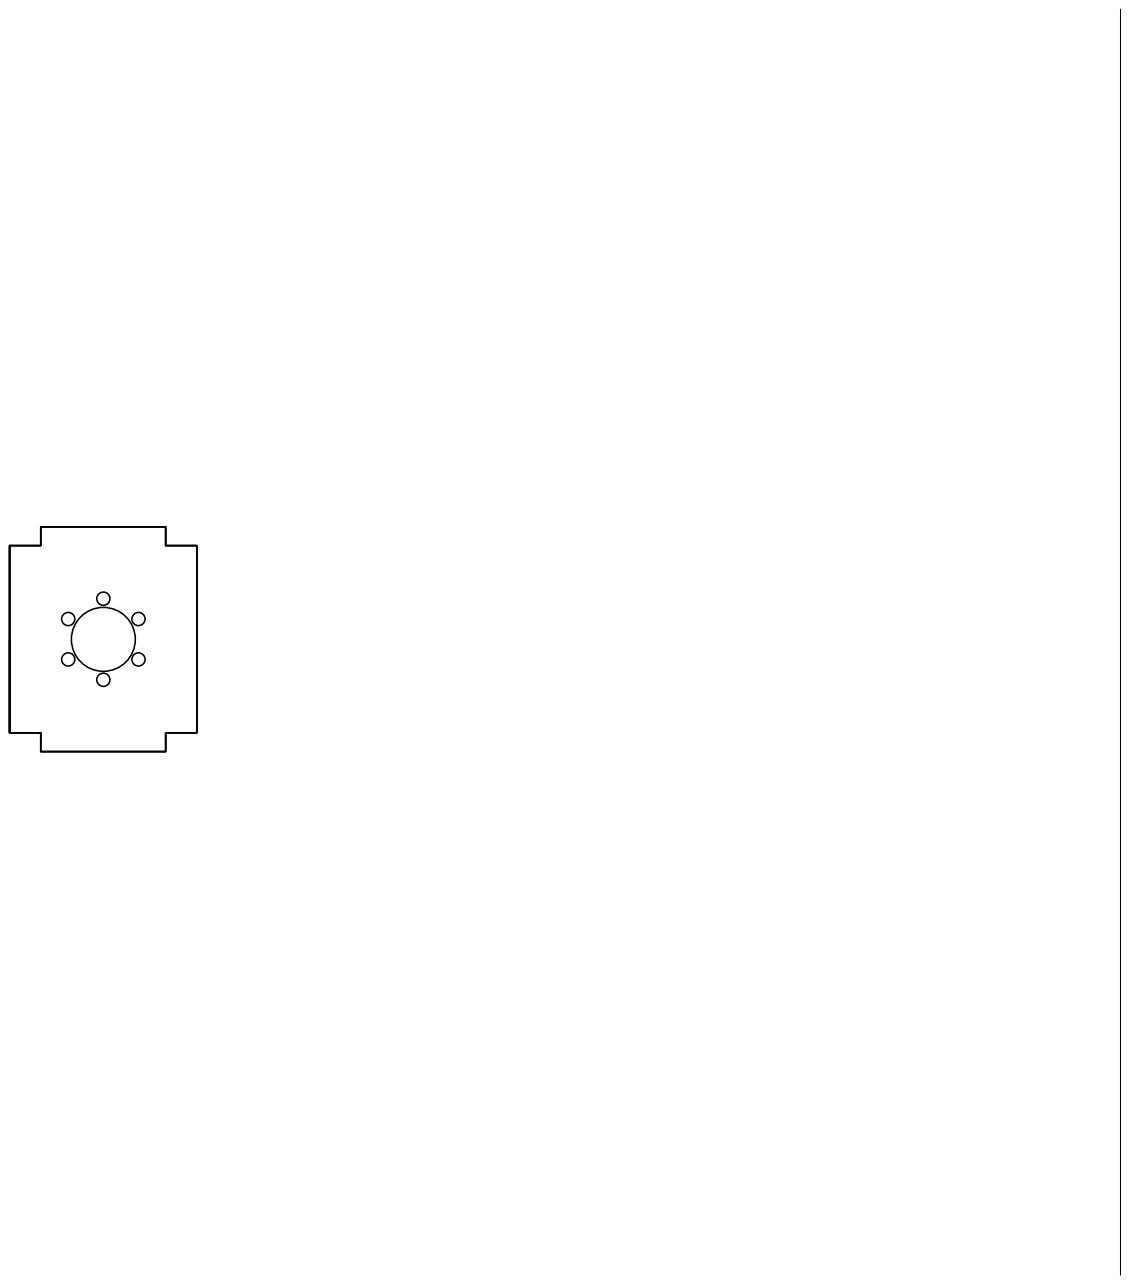
[picture p32: page 1]
