LJ-STAND/Design-2017/EAGLE/LJ-STAND/Dribbler.brd

## EAGLE design EAGLE/LJ-STAND/Dribbler.brd (2017-04-06)

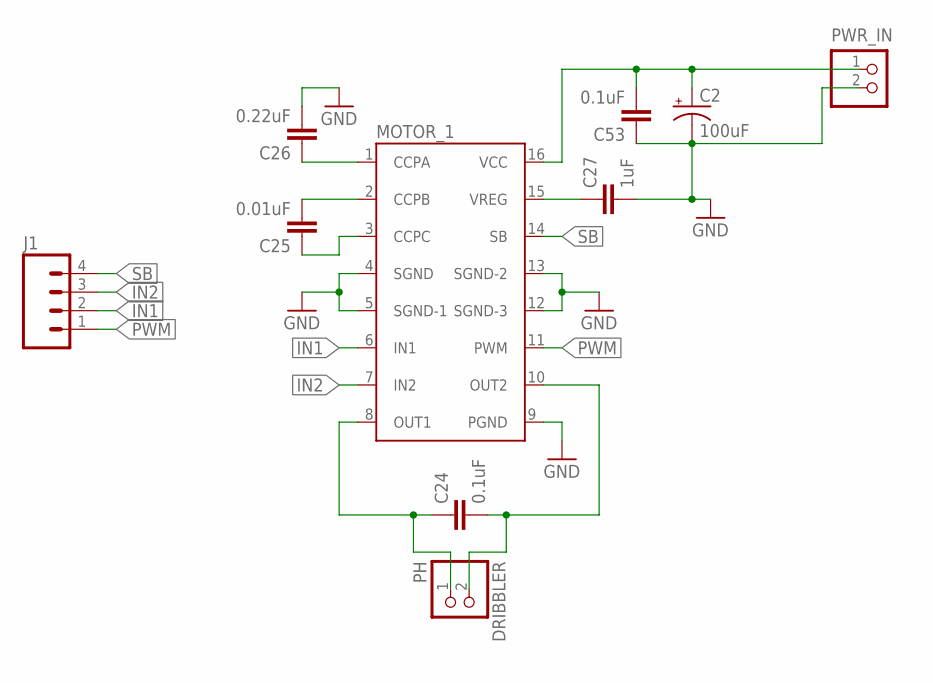
[picture p33: schematic Dribbler.sch, sheet 2]

Parts:
C2: 100uF; CPOL-RADIAL-100UF-25V
C24, C53: 0.1uF; 0603-CAP
C25: 0.01uF; 0603-CAP
C26: 0.22uF; 0603-CAP
C27: 1uF; 0603-CAP
DRIBBLER: PH; JST-PH-2-THM
J1: M04PTH; 1X04
MOTOR_1: TB6549PG
PWR_IN: B2P-VH

Connections:
GND: C2.2 (-), C26.2, C27.2, C53.1, MOTOR_1.4 (SGND), MOTOR_1.5 (SGND-1), MOTOR_1.9 (PGND), MOTOR_1.12 (SGND-3), MOTOR_1.13 (SGND-2), PWR_IN.2
IN1: J1.2, MOTOR_1.6 (IN1)
IN2: J1.3, MOTOR_1.7 (IN2)
MOTOR_PWR: C2.1 (+), C53.2, MOTOR_1.16 (VCC), PWR_IN.1
unnamed: C24.1, DRIBBLER.1 (2), MOTOR_1.8 (OUT1)
unnamed: C24.2, DRIBBLER.2 (1), MOTOR_1.10 (OUT2)
unnamed: C25.2, MOTOR_1.2 (CCPB)
unnamed: C25.1, MOTOR_1.3 (CCPC)
unnamed: C26.1, MOTOR_1.1 (CCPA)
unnamed: C27.1, MOTOR_1.15 (VREG)
PWM: J1.1, MOTOR_1.11 (PWM)
SB: J1.4, MOTOR_1.14 (SB)

Board: 2 copper layers, 10 parts (6 on the bottom side), 12 nets, no tracks yet.
