LJ-STAND/Design-2017/EAGLE/LJ-STAND/Main.brd

## EAGLE design EAGLE/LJ-STAND/Main.brd (2017-03-21)

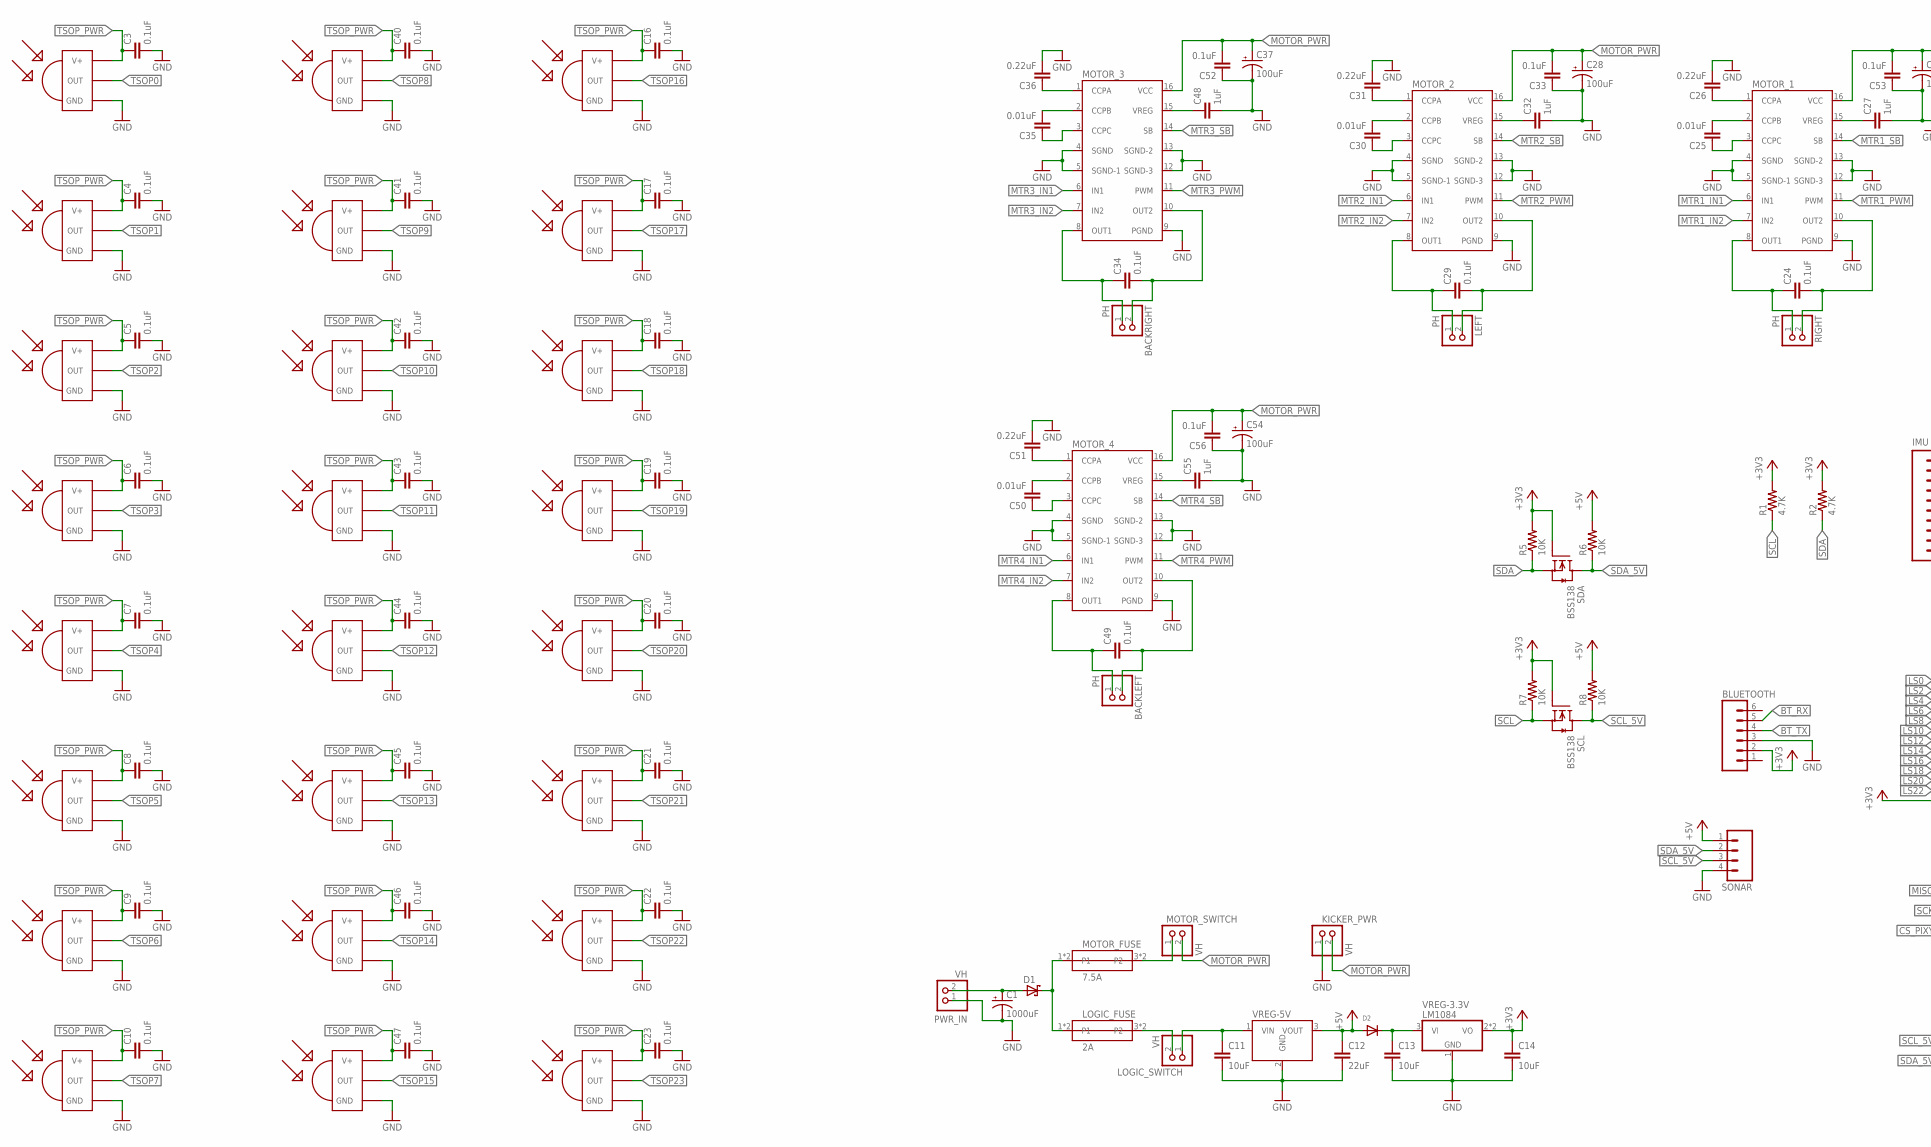
[picture p34: schematic Main.sch, part in row 1, column 1]

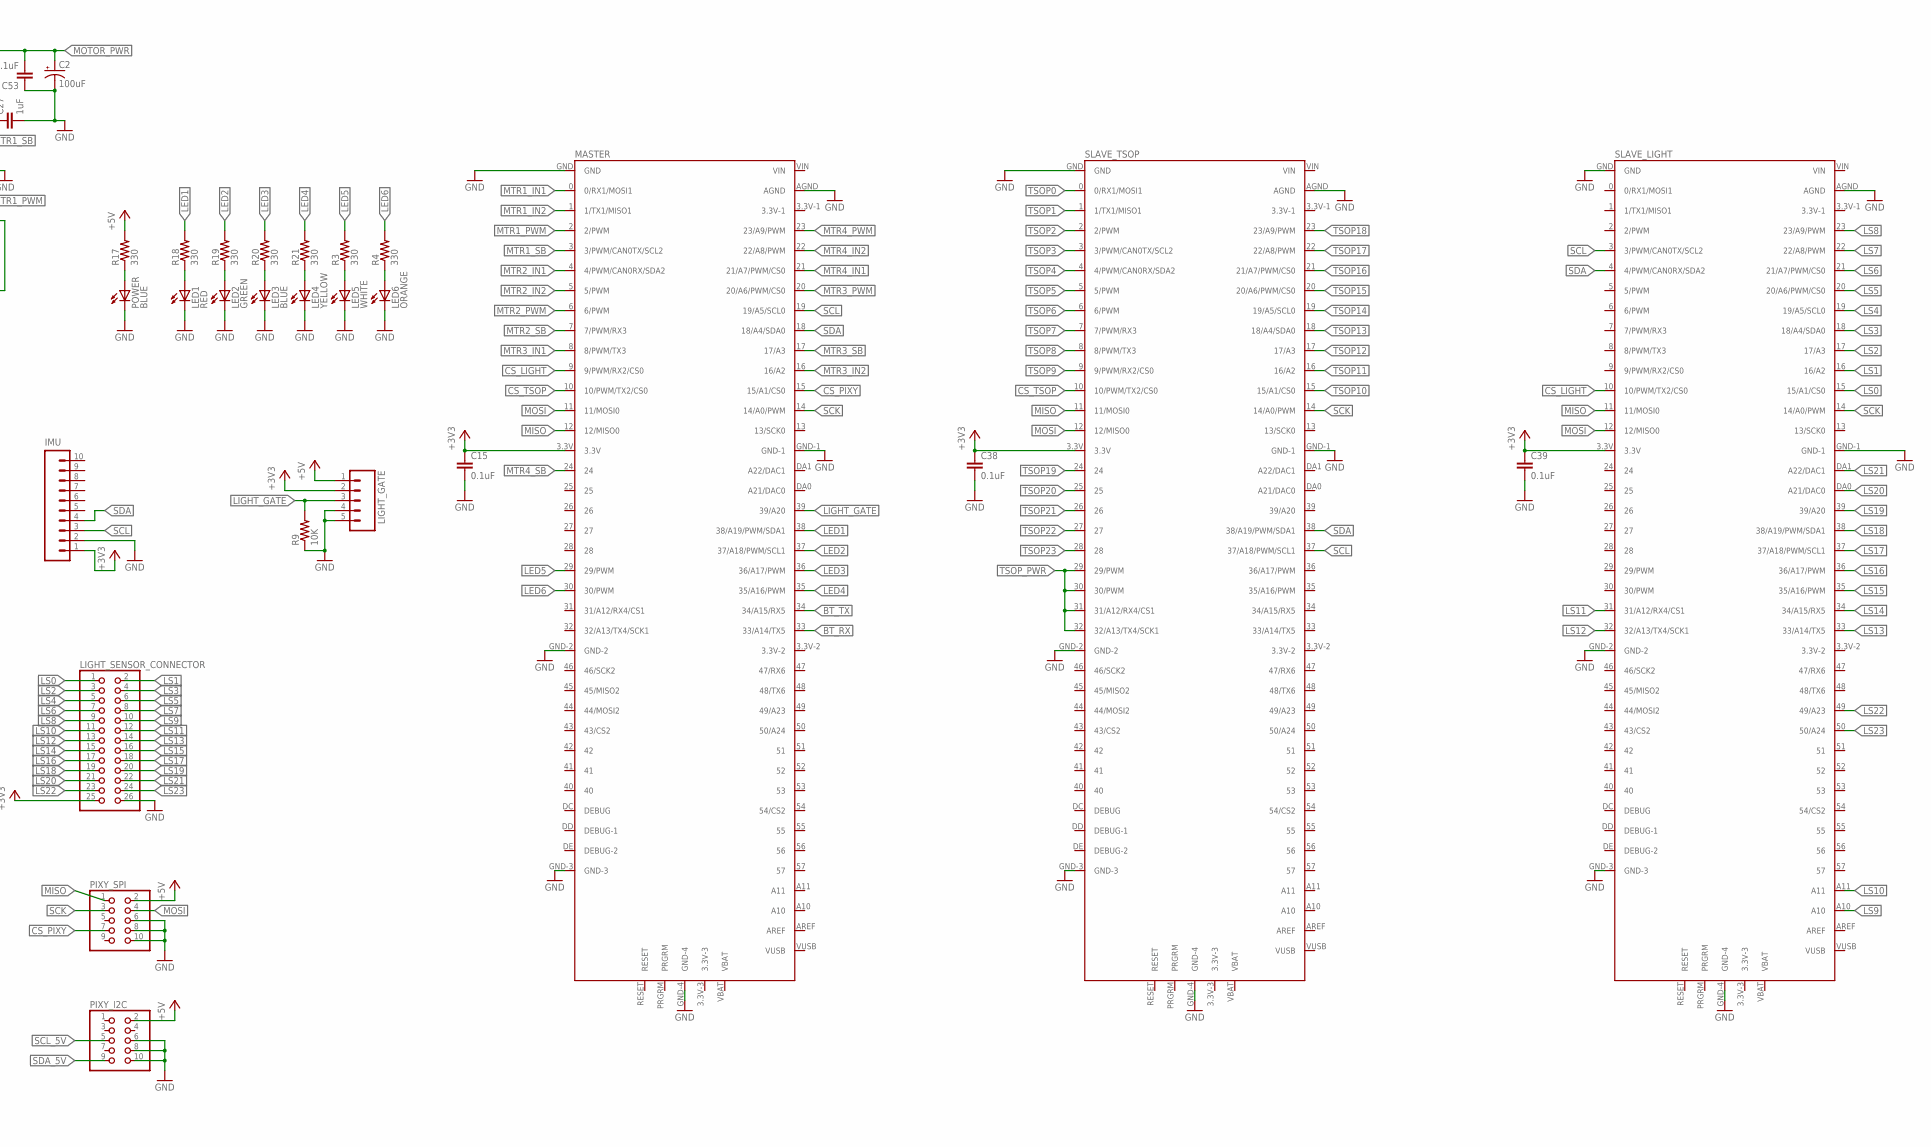
[picture p35: schematic Main.sch, part in row 1, column 2]

Parts:
0, 1, 2, 3, 4, 5, 6, 7, 8, 9, 10, 11, 12, 13, 14, 15, 16, 17, 18, 19, 20, 21, 22, 23: TSOP1737; TSOP17XX
BACKLEFT: PH; JST-PH-2-THM
BACKRIGHT: PH; JST-PH-2-THM
BLUETOOTH: M06SILK_FEMALE_PTH; 1X06
C1: 1000uF; CPOL-RADIAL-1000UF-25V
C2, C28, C37, C54: 100uF; CPOL-RADIAL-100UF-25V
C3, C4, C5, C6, C7, C8, C9, C10, C15, C16, C17, C18, C19, C20, C21, C22, C23, C24, C29, C33, C34, C38, C39, C40, C41, C42, C43, C44, C45, C46, C47, C49, C52, C53, C56: 0.1uF; 0603-CAP
C11, C13, C14: 10uF; 0805
C12: 22uF; 0805
C25, C30, C35, C50: 0.01uF; 0603-CAP
C26, C31, C36, C51: 0.22uF; 0603-CAP
C27, C32, C48, C55: 1uF; 0603-CAP
D1: SCHOTTKY-DIODEP6T15; P6T15
D2: DIODE_SOD-123FL; SOD-123FL
IMU: M10SILK_FEMALE_PTH; 1X10
KICKER_PWR: VH; B2P-VH
LED1: RED; CHIPLED_0603
LED2: GREEN; CHIPLED_0603
LED3: BLUE; CHIPLED_0603
LED4: YELLOW; CHIPLED_0603
LED5: WHITE; CHIPLED_0603
LED6: ORANGE; CHIPLED_0603
LEFT: PH; JST-PH-2-THM
LIGHT_GATE: M05PTH; 1X05
LIGHT_SENSOR_CONNECTOR: PINHD-2X13SMT; 2X13_SMT
LOGIC_FUSE: 2A; 3568-FUSEHOLDER
LOGIC_SWITCH: VH; B2P-VH
MASTER: TEENSY-3.5
MOTOR_1, MOTOR_2, MOTOR_3, MOTOR_4: TB6549PG
MOTOR_FUSE: 7.5A; 3568-FUSEHOLDER
MOTOR_SWITCH: VH; B2P-VH
PIXY_I2C: PINHD-2X5SMT; 2X05_SMT
PIXY_SPI: PINHD-2X5SMT; 2X05_SMT
POWER: BLUE; CHIPLED_0603
PWR_IN: VH; B2P-VH
R1, R2: 4.7K; 0603-RES
R3, R4, R17, R18, R19, R20, R21: 330; 0603-RES
R5, R6, R7, R8, R9: 10K; 0603-RES
RIGHT: PH; JST-PH-2-THM
SCL: BSS138; SOT23
SDA: BSS138; SOT23
SLAVE_LIGHT: TEENSY-3.5
SLAVE_TSOP: TEENSY-3.5
SONAR: M04PTH; 1X04
VREG-3.3V: LM1084; TO263-3
VREG-5V: V78-2000

Connections:
+3V3: BLUETOOTH.2, C14.1, C15.1, C38.1, C39.1, IMU.1, LIGHT_GATE.2, LIGHT_SENSOR_CONNECTOR.25, MASTER.3.3V, R1.2, R2.2, R5.2, R7.2, SCL.1 (G), SDA.1 (G), SLAVE_LIGHT.3.3V, SLAVE_TSOP.3.3V, VREG-3.3V.2 (VO), VREG-3.3V.TAB (VO)
+5V: C12.1, D2.A, LIGHT_GATE.1, PIXY_I2C.2, PIXY_SPI.2, R6.2, R8.2, R17.2, SONAR.1, VREG-5V.3 (VOUT)
BT_RX: BLUETOOTH.5, MASTER.33 (33/A14/TX5)
BT_TX: BLUETOOTH.4, MASTER.34 (34/A15/RX5)
CS_LIGHT: MASTER.9 (9/PWM/RX2/CS0), SLAVE_LIGHT.10 (10/PWM/TX2/CS0)
CS_PIXY: MASTER.15 (15/A1/CS0), PIXY_SPI.7
CS_TSOP: MASTER.10 (10/PWM/TX2/CS0), SLAVE_TSOP.10 (10/PWM/TX2/CS0)
GND: 0.GND, 1.GND, 2.GND, 3.GND, 4.GND, 5.GND, 6.GND, 7.GND, 8.GND, 9.GND, 10.GND, 11.GND, 12.GND, 13.GND, 14.GND, 15.GND, 16.GND, 17.GND, 18.GND, 19.GND, 20.GND, 21.GND, 22.GND, 23.GND, BLUETOOTH.3, C1.-, C2.2 (-), C3.2, C4.2, C5.2, C6.2, C7.2, C8.2, C9.2, C10.2, C11.2, C12.2, C13.2, C14.2, C15.2, C16.2, C17.2, C18.2, C19.2, C20.2, C21.2, C22.2, C23.2, C26.2, C27.2, C28.2 (-), C31.2, C32.2, C33.1, C36.2, C37.2 (-), C38.2, C39.2, C40.2, C41.2, C42.2, C43.2, C44.2, C45.2, C46.2, C47.2, C48.2, C51.2, C52.1, C53.1, C54.2 (-), C55.2, C56.1, IMU.2, KICKER_PWR.1, LED1.C, LED2.C, LED3.C, LED4.C, LED5.C, LED6.C, LIGHT_GATE.4, LIGHT_GATE.5, LIGHT_SENSOR_CONNECTOR.26, MASTER.AGND, MASTER.GND, MASTER.GND-1, MASTER.GND-2, MASTER.GND-3, MASTER.GND-4, MOTOR_1.4 (SGND), MOTOR_1.5 (SGND-1), MOTOR_1.9 (PGND), MOTOR_1.12 (SGND-3), MOTOR_1.13 (SGND-2), MOTOR_2.4 (SGND), MOTOR_2.5 (SGND-1), MOTOR_2.9 (PGND), MOTOR_2.12 (SGND-3), MOTOR_2.13 (SGND-2), MOTOR_3.4 (SGND), MOTOR_3.5 (SGND-1), MOTOR_3.9 (PGND), MOTOR_3.12 (SGND-3), MOTOR_3.13 (SGND-2), MOTOR_4.4 (SGND), MOTOR_4.5 (SGND-1), MOTOR_4.9 (PGND), MOTOR_4.12 (SGND-3), MOTOR_4.13 (SGND-2), PIXY_I2C.6, PIXY_I2C.8, PIXY_I2C.10, PIXY_SPI.6, PIXY_SPI.8, PIXY_SPI.10, POWER.C, PWR_IN.1, R9.1, SLAVE_LIGHT.AGND, SLAVE_LIGHT.GND, SLAVE_LIGHT.GND-1, SLAVE_LIGHT.GND-2, SLAVE_LIGHT.GND-3, SLAVE_LIGHT.GND-4, SLAVE_TSOP.AGND, SLAVE_TSOP.GND, SLAVE_TSOP.GND-1, SLAVE_TSOP.GND-2, SLAVE_TSOP.GND-3, SLAVE_TSOP.GND-4, SONAR.4, VREG-3.3V.1 (GND), VREG-5V.2 (GND)
LED1: MASTER.38 (38/A19/PWM/SDA1), R18.2
LED2: MASTER.37 (37/A18/PWM/SCL1), R19.2
LED3: MASTER.36 (36/A17/PWM), R20.2
LED4: MASTER.35 (35/A16/PWM), R21.2
LED5: MASTER.29 (29/PWM), R3.2
LED6: MASTER.30 (30/PWM), R4.2
LIGHT_GATE: LIGHT_GATE.3, MASTER.39 (39/A20), R9.2
LS0: LIGHT_SENSOR_CONNECTOR.1, SLAVE_LIGHT.15 (15/A1/CS0)
LS1: LIGHT_SENSOR_CONNECTOR.2, SLAVE_LIGHT.16 (16/A2)
LS2: LIGHT_SENSOR_CONNECTOR.3, SLAVE_LIGHT.17 (17/A3)
LS3: LIGHT_SENSOR_CONNECTOR.4, SLAVE_LIGHT.18 (18/A4/SDA0)
LS4: LIGHT_SENSOR_CONNECTOR.5, SLAVE_LIGHT.19 (19/A5/SCL0)
LS5: LIGHT_SENSOR_CONNECTOR.6, SLAVE_LIGHT.20 (20/A6/PWM/CS0)
LS6: LIGHT_SENSOR_CONNECTOR.7, SLAVE_LIGHT.21 (21/A7/PWM/CS0)
LS7: LIGHT_SENSOR_CONNECTOR.8, SLAVE_LIGHT.22 (22/A8/PWM)
LS8: LIGHT_SENSOR_CONNECTOR.9, SLAVE_LIGHT.23 (23/A9/PWM)
LS9: LIGHT_SENSOR_CONNECTOR.10, SLAVE_LIGHT.A10
LS10: LIGHT_SENSOR_CONNECTOR.11, SLAVE_LIGHT.A11
LS11: LIGHT_SENSOR_CONNECTOR.12, SLAVE_LIGHT.31 (31/A12/RX4/CS1)
LS12: LIGHT_SENSOR_CONNECTOR.13, SLAVE_LIGHT.32 (32/A13/TX4/SCK1)
LS13: LIGHT_SENSOR_CONNECTOR.14, SLAVE_LIGHT.33 (33/A14/TX5)
LS14: LIGHT_SENSOR_CONNECTOR.15, SLAVE_LIGHT.34 (34/A15/RX5)
LS15: LIGHT_SENSOR_CONNECTOR.16, SLAVE_LIGHT.35 (35/A16/PWM)
LS16: LIGHT_SENSOR_CONNECTOR.17, SLAVE_LIGHT.36 (36/A17/PWM)
LS17: LIGHT_SENSOR_CONNECTOR.18, SLAVE_LIGHT.37 (37/A18/PWM/SCL1)
LS18: LIGHT_SENSOR_CONNECTOR.19, SLAVE_LIGHT.38 (38/A19/PWM/SDA1)
LS19: LIGHT_SENSOR_CONNECTOR.20, SLAVE_LIGHT.39 (39/A20)
LS20: LIGHT_SENSOR_CONNECTOR.21, SLAVE_LIGHT.DA0 (A21/DAC0)
LS21: LIGHT_SENSOR_CONNECTOR.22, SLAVE_LIGHT.DA1 (A22/DAC1)
LS22: LIGHT_SENSOR_CONNECTOR.23, SLAVE_LIGHT.49 (49/A23)
LS23: LIGHT_SENSOR_CONNECTOR.24, SLAVE_LIGHT.50 (50/A24)
MISO: MASTER.12 (12/MISO0), PIXY_SPI.1, SLAVE_LIGHT.11 (11/MOSI0), SLAVE_TSOP.11 (11/MOSI0)
MOSI: MASTER.11 (11/MOSI0), PIXY_SPI.4, SLAVE_LIGHT.12 (12/MISO0), SLAVE_TSOP.12 (12/MISO0)
MOTOR_PWR: C2.1 (+), C28.1 (+), C33.2, C37.1 (+), C52.2, C53.2, C54.1 (+), C56.2, KICKER_PWR.2, MOTOR_1.16 (VCC), MOTOR_2.16 (VCC), MOTOR_3.16 (VCC), MOTOR_4.16 (VCC), MOTOR_SWITCH.2
MTR1_IN1: MASTER.0 (0/RX1/MOSI1), MOTOR_1.6 (IN1)
MTR1_IN2: MASTER.1 (1/TX1/MISO1), MOTOR_1.7 (IN2)
MTR1_PWM: MASTER.2 (2/PWM), MOTOR_1.11 (PWM)
MTR1_SB: MASTER.3 (3/PWM/CAN0TX/SCL2), MOTOR_1.14 (SB)
MTR2_IN1: MASTER.4 (4/PWM/CAN0RX/SDA2), MOTOR_2.6 (IN1)
MTR2_IN2: MASTER.5 (5/PWM), MOTOR_2.7 (IN2)
MTR2_PWM: MASTER.6 (6/PWM), MOTOR_2.11 (PWM)
MTR2_SB: MASTER.7 (7/PWM/RX3), MOTOR_2.14 (SB)
MTR3_IN1: MASTER.8 (8/PWM/TX3), MOTOR_3.6 (IN1)
MTR3_IN2: MASTER.16 (16/A2), MOTOR_3.7 (IN2)
MTR3_PWM: MASTER.20 (20/A6/PWM/CS0), MOTOR_3.11 (PWM)
MTR3_SB: MASTER.17 (17/A3), MOTOR_3.14 (SB)
MTR4_IN1: MASTER.21 (21/A7/PWM/CS0), MOTOR_4.6 (IN1)
MTR4_IN2: MASTER.22 (22/A8/PWM), MOTOR_4.7 (IN2)
MTR4_PWM: MASTER.23 (23/A9/PWM), MOTOR_4.11 (PWM)
MTR4_SB: MASTER.24, MOTOR_4.14 (SB)
unnamed: C29.1, LEFT.1 (2), MOTOR_2.8 (OUT1)
unnamed: C29.2, LEFT.2 (1), MOTOR_2.10 (OUT2)
unnamed: C30.2, MOTOR_2.2 (CCPB)
unnamed: C30.1, MOTOR_2.3 (CCPC)
unnamed: C24.1, MOTOR_1.8 (OUT1), RIGHT.1 (2)
unnamed: C31.1, MOTOR_2.1 (CCPA)
unnamed: C24.2, MOTOR_1.10 (OUT2), RIGHT.2 (1)
unnamed: C48.1, MOTOR_3.15 (VREG)
unnamed: LOGIC_FUSE.3 (P2), LOGIC_FUSE.4 (P2), LOGIC_SWITCH.2
unnamed: C25.2, MOTOR_1.2 (CCPB)
unnamed: C11.1, LOGIC_SWITCH.1, VREG-5V.1 (VIN)
unnamed: C25.1, MOTOR_1.3 (CCPC)
unnamed: C26.1, MOTOR_1.1 (CCPA)
unnamed: BACKRIGHT.1 (2), C34.1, MOTOR_3.8 (OUT1)
unnamed: C27.1, MOTOR_1.15 (VREG)
unnamed: BACKRIGHT.2 (1), C34.2, MOTOR_3.10 (OUT2)
unnamed: C35.2, MOTOR_3.2 (CCPB)
unnamed: C35.1, MOTOR_3.3 (CCPC)
unnamed: C36.1, MOTOR_3.1 (CCPA)
unnamed: C55.1, MOTOR_4.15 (VREG)
unnamed: MOTOR_FUSE.3 (P2), MOTOR_FUSE.4 (P2), MOTOR_SWITCH.1
unnamed: BACKLEFT.1 (2), C49.1, MOTOR_4.8 (OUT1)
unnamed: LED2.A, R19.1
unnamed: LED3.A, R20.1
unnamed: LED4.A, R21.1
unnamed: BACKLEFT.2 (1), C49.2, MOTOR_4.10 (OUT2)
unnamed: POWER.A, R17.1
unnamed: C50.2, MOTOR_4.2 (CCPB)
unnamed: LED1.A, R18.1
unnamed: C50.1, MOTOR_4.3 (CCPC)
unnamed: C51.1, MOTOR_4.1 (CCPA)
unnamed: C32.1, MOTOR_2.15 (VREG)
unnamed: LED5.A, R3.1
unnamed: LED6.A, R4.1
unnamed: C1.+, D1.A, PWR_IN.2
unnamed: C13.1, D2.C, VREG-3.3V.3 (VI)
PWR: D1.C, LOGIC_FUSE.1, LOGIC_FUSE.2 (P1), MOTOR_FUSE.1, MOTOR_FUSE.2 (P1)
SCK: MASTER.14 (14/A0/PWM), PIXY_SPI.3, SLAVE_LIGHT.14 (14/A0/PWM), SLAVE_TSOP.14 (14/A0/PWM)
SCL: IMU.3, MASTER.19 (19/A5/SCL0), R1.1, R7.1, SCL.2 (S), SLAVE_LIGHT.3 (3/PWM/CAN0TX/SCL2), SLAVE_TSOP.37 (37/A18/PWM/SCL1)
SCL_5V: PIXY_I2C.5, R8.1, SCL.3 (D), SONAR.3
SDA: IMU.4, MASTER.18 (18/A4/SDA0), R2.1, R5.1, SDA.2 (S), SLAVE_LIGHT.4 (4/PWM/CAN0RX/SDA2), SLAVE_TSOP.38 (38/A19/PWM/SDA1)
SDA_5V: PIXY_I2C.9, R6.1, SDA.3 (D), SONAR.2
TSOP0: 0.OUT, SLAVE_TSOP.0 (0/RX1/MOSI1)
TSOP1: 1.OUT, SLAVE_TSOP.1 (1/TX1/MISO1)
TSOP2: 2.OUT, SLAVE_TSOP.2 (2/PWM)
TSOP3: 3.OUT, SLAVE_TSOP.3 (3/PWM/CAN0TX/SCL2)
TSOP4: 4.OUT, SLAVE_TSOP.4 (4/PWM/CAN0RX/SDA2)
TSOP5: 5.OUT, SLAVE_TSOP.5 (5/PWM)
TSOP6: 6.OUT, SLAVE_TSOP.6 (6/PWM)
TSOP7: 7.OUT, SLAVE_TSOP.7 (7/PWM/RX3)
TSOP8: 8.OUT, SLAVE_TSOP.8 (8/PWM/TX3)
TSOP9: 9.OUT, SLAVE_TSOP.9 (9/PWM/RX2/CS0)
TSOP10: 10.OUT, SLAVE_TSOP.15 (15/A1/CS0)
TSOP11: 11.OUT, SLAVE_TSOP.16 (16/A2)
TSOP12: 12.OUT, SLAVE_TSOP.17 (17/A3)
TSOP13: 13.OUT, SLAVE_TSOP.18 (18/A4/SDA0)
TSOP14: 14.OUT, SLAVE_TSOP.19 (19/A5/SCL0)
TSOP15: 15.OUT, SLAVE_TSOP.20 (20/A6/PWM/CS0)
TSOP16: 16.OUT, SLAVE_TSOP.21 (21/A7/PWM/CS0)
TSOP17: 17.OUT, SLAVE_TSOP.22 (22/A8/PWM)
TSOP18: 18.OUT, SLAVE_TSOP.23 (23/A9/PWM)
TSOP19: 19.OUT, SLAVE_TSOP.24
TSOP20: 20.OUT, SLAVE_TSOP.25
TSOP21: 21.OUT, SLAVE_TSOP.26
TSOP22: 22.OUT, SLAVE_TSOP.27
TSOP23: 23.OUT, SLAVE_TSOP.28
TSOP_PWR: 0.V+, 1.V+, 2.V+, 3.V+, 4.V+, 5.V+, 6.V+, 7.V+, 8.V+, 9.V+, 10.V+, 11.V+, 12.V+, 13.V+, 14.V+, 15.V+, 16.V+, 17.V+, 18.V+, 19.V+, 20.V+, 21.V+, 22.V+, 23.V+, C3.1, C4.1, C5.1, C6.1, C7.1, C8.1, C9.1, C10.1, C16.1, C17.1, C18.1, C19.1, C20.1, C21.1, C22.1, C23.1, C40.1, C41.1, C42.1, C43.1, C44.1, C45.1, C46.1, C47.1, SLAVE_TSOP.29 (29/PWM), SLAVE_TSOP.30 (30/PWM), SLAVE_TSOP.31 (31/A12/RX4/CS1), SLAVE_TSOP.32 (32/A13/TX4/SCK1)

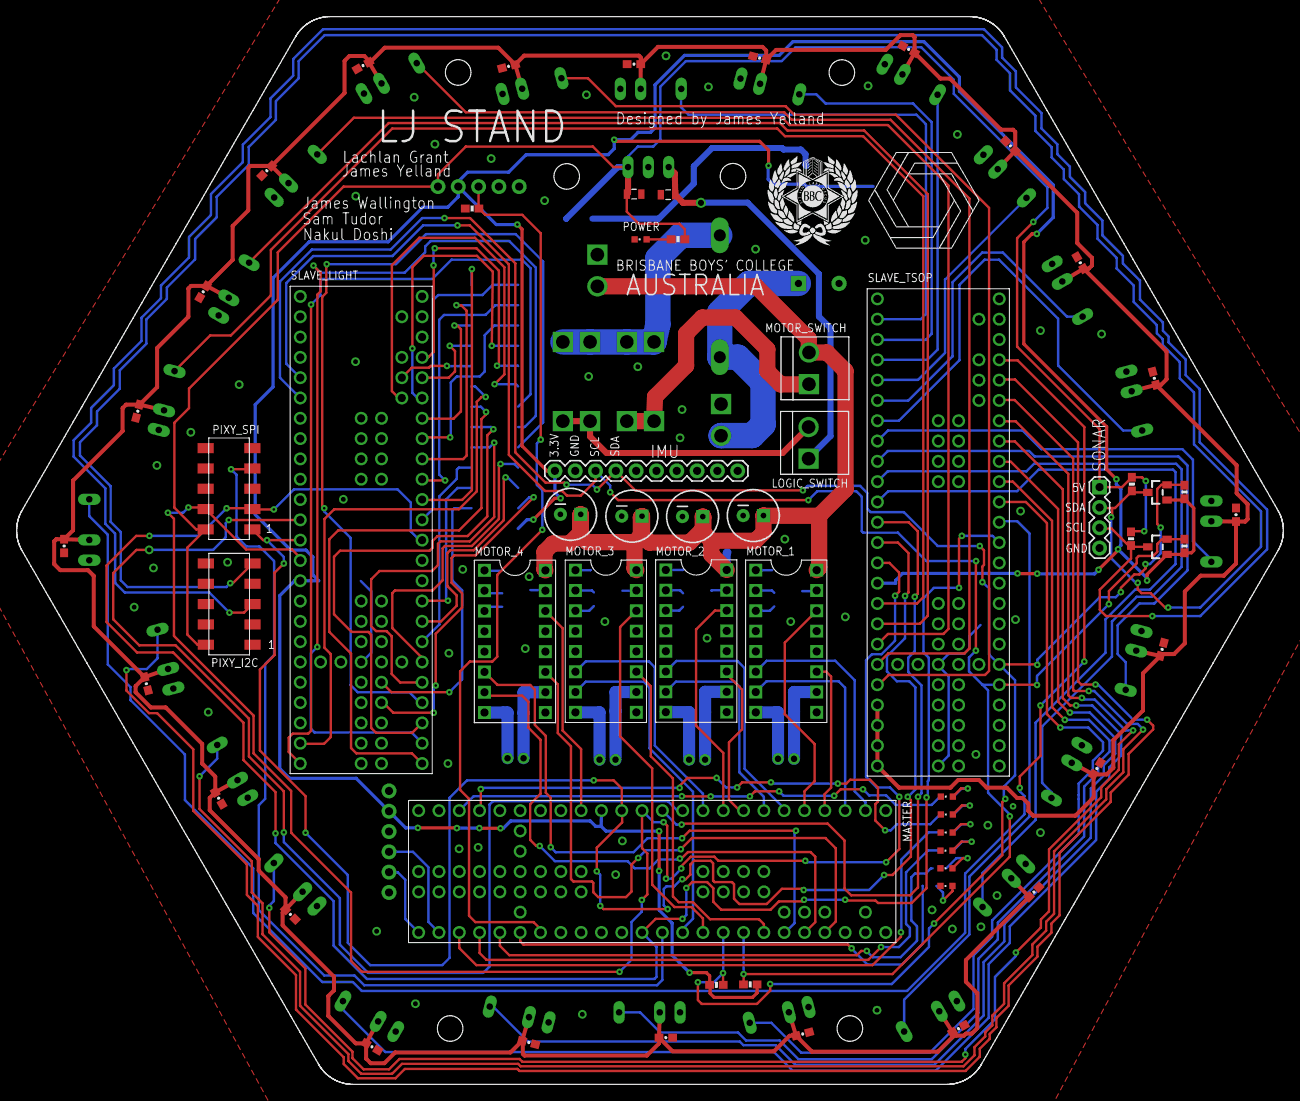
[picture p36: board Main.brd from above]

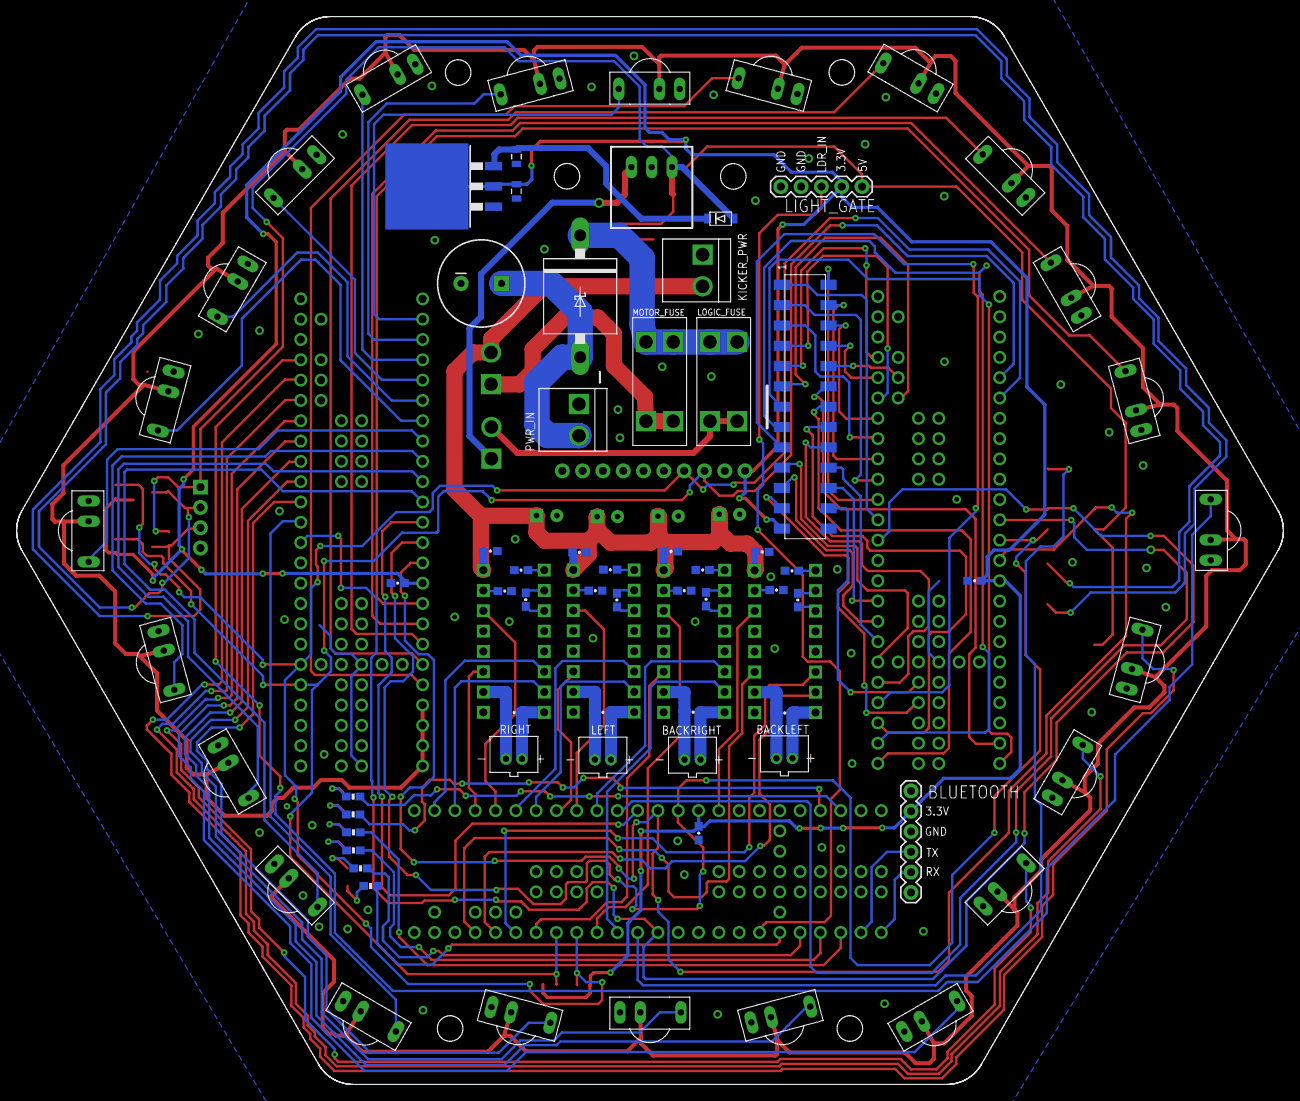
[picture p37: board Main.brd from below]

Board: 2 copper layers, 158.5 x 133.6 mm, 131 parts (71 on the bottom side), 125 nets.
