LJ-STAND/Design-2017/EAGLE/LJ-STAND/Light Sensor.brd

## EAGLE design EAGLE/LJ-STAND/Light Sensor.brd (2016-12-03)

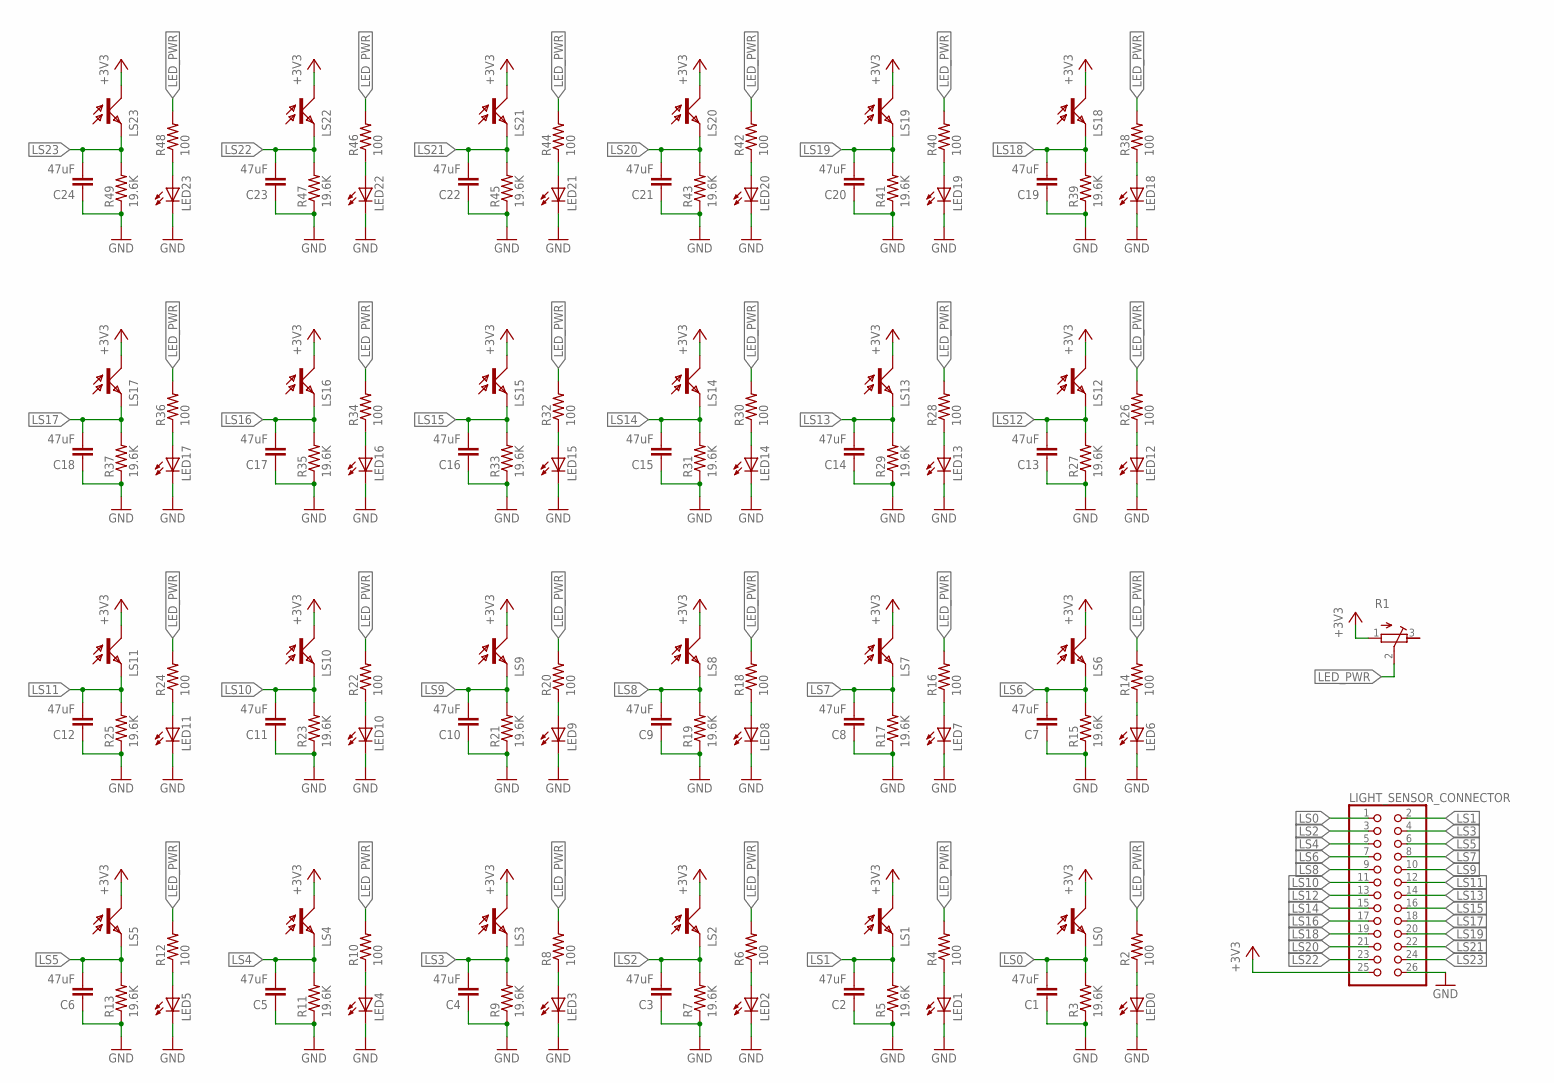
[picture p38: schematic Light Sensor.sch]

Parts:
C1, C2, C3, C4, C5, C6, C7, C8, C9, C10, C11, C12, C13, C14, C15, C16, C17, C18, C19, C20, C21, C22, C23, C24: 47uF; 1206
LED0, LED1, LED2, LED3, LED4, LED5, LED6, LED7, LED8, LED9, LED10, LED11, LED12, LED13, LED14, LED15, LED16, LED17, LED18, LED19, LED20, LED21, LED22, LED23: LEDCHIP-LED0603; CHIP-LED0603
LIGHT_SENSOR_CONNECTOR: PINHD-2X13SMT; 2X13_SMT
LS0, LS1, LS2, LS3, LS4, LS5, LS6, LS7, LS8, LS9, LS10, LS11, LS12, LS13, LS14, LS15, LS16, LS17, LS18, LS19, LS20, LS21, LS22, LS23: ALS; SMD
R1: R-TRIMM3296W; RTRIM3296W
R2, R4, R6, R8, R10, R12, R14, R16, R18, R20, R22, R24, R26, R28, R30, R32, R34, R36, R38, R40, R42, R44, R46, R48: 100; 0603-RES
R3, R5, R7, R9, R11, R13, R15, R17, R19, R21, R23, R25, R27, R29, R31, R33, R35, R37, R39, R41, R43, R45, R47, R49: 19.6K; 0603-RES

Connections:
+3V3: LIGHT_SENSOR_CONNECTOR.25, LS0.C, LS1.C, LS2.C, LS3.C, LS4.C, LS5.C, LS6.C, LS7.C, LS8.C, LS9.C, LS10.C, LS11.C, LS12.C, LS13.C, LS14.C, LS15.C, LS16.C, LS17.C, LS18.C, LS19.C, LS20.C, LS21.C, LS22.C, LS23.C, R1.1 (A)
GND: C1.1, C2.1, C3.1, C4.1, C5.1, C6.1, C7.1, C8.1, C9.1, C10.1, C11.1, C12.1, C13.1, C14.1, C15.1, C16.1, C17.1, C18.1, C19.1, C20.1, C21.1, C22.1, C23.1, C24.1, LED0.C, LED1.C, LED2.C, LED3.C, LED4.C, LED5.C, LED6.C, LED7.C, LED8.C, LED9.C, LED10.C, LED11.C, LED12.C, LED13.C, LED14.C, LED15.C, LED16.C, LED17.C, LED18.C, LED19.C, LED20.C, LED21.C, LED22.C, LED23.C, LIGHT_SENSOR_CONNECTOR.26, R3.1, R5.1, R7.1, R9.1, R11.1, R13.1, R15.1, R17.1, R19.1, R21.1, R23.1, R25.1, R27.1, R29.1, R31.1, R33.1, R35.1, R37.1, R39.1, R41.1, R43.1, R45.1, R47.1, R49.1
LED_PWR: R1.2 (S), R2.2, R4.2, R6.2, R8.2, R10.2, R12.2, R14.2, R16.2, R18.2, R20.2, R22.2, R24.2, R26.2, R28.2, R30.2, R32.2, R34.2, R36.2, R38.2, R40.2, R42.2, R44.2, R46.2, R48.2
LS0: C1.2, LIGHT_SENSOR_CONNECTOR.1, LS0.E, R3.2
LS1: C2.2, LIGHT_SENSOR_CONNECTOR.2, LS1.E, R5.2
LS2: C3.2, LIGHT_SENSOR_CONNECTOR.3, LS2.E, R7.2
LS3: C4.2, LIGHT_SENSOR_CONNECTOR.4, LS3.E, R9.2
LS4: C5.2, LIGHT_SENSOR_CONNECTOR.5, LS4.E, R11.2
LS5: C6.2, LIGHT_SENSOR_CONNECTOR.6, LS5.E, R13.2
LS6: C7.2, LIGHT_SENSOR_CONNECTOR.7, LS6.E, R15.2
LS7: C8.2, LIGHT_SENSOR_CONNECTOR.8, LS7.E, R17.2
LS8: C9.2, LIGHT_SENSOR_CONNECTOR.9, LS8.E, R19.2
LS9: C10.2, LIGHT_SENSOR_CONNECTOR.10, LS9.E, R21.2
LS10: C11.2, LIGHT_SENSOR_CONNECTOR.11, LS10.E, R23.2
LS11: C12.2, LIGHT_SENSOR_CONNECTOR.12, LS11.E, R25.2
LS12: C13.2, LIGHT_SENSOR_CONNECTOR.13, LS12.E, R27.2
LS13: C14.2, LIGHT_SENSOR_CONNECTOR.14, LS13.E, R29.2
LS14: C15.2, LIGHT_SENSOR_CONNECTOR.15, LS14.E, R31.2
LS15: C16.2, LIGHT_SENSOR_CONNECTOR.16, LS15.E, R33.2
LS16: C17.2, LIGHT_SENSOR_CONNECTOR.17, LS16.E, R35.2
LS17: C18.2, LIGHT_SENSOR_CONNECTOR.18, LS17.E, R37.2
LS18: C19.2, LIGHT_SENSOR_CONNECTOR.19, LS18.E, R39.2
LS19: C20.2, LIGHT_SENSOR_CONNECTOR.20, LS19.E, R41.2
LS20: C21.2, LIGHT_SENSOR_CONNECTOR.21, LS20.E, R43.2
LS21: C22.2, LIGHT_SENSOR_CONNECTOR.22, LS21.E, R45.2
LS22: C23.2, LIGHT_SENSOR_CONNECTOR.23, LS22.E, R47.2
LS23: C24.2, LIGHT_SENSOR_CONNECTOR.24, LS23.E, R49.2
unnamed: LED0.A, R2.1
unnamed: LED1.A, R4.1
unnamed: LED2.A, R6.1
unnamed: LED3.A, R8.1
unnamed: LED4.A, R10.1
unnamed: LED5.A, R12.1
unnamed: LED6.A, R14.1
unnamed: LED7.A, R16.1
unnamed: LED8.A, R18.1
unnamed: LED9.A, R20.1
unnamed: LED10.A, R22.1
unnamed: LED11.A, R24.1
unnamed: LED12.A, R26.1
unnamed: LED13.A, R28.1
unnamed: LED14.A, R30.1
unnamed: LED15.A, R32.1
unnamed: LED16.A, R34.1
unnamed: LED17.A, R36.1
unnamed: LED18.A, R38.1
unnamed: LED19.A, R40.1
unnamed: LED20.A, R42.1
unnamed: LED21.A, R44.1
unnamed: LED22.A, R46.1
unnamed: LED23.A, R48.1

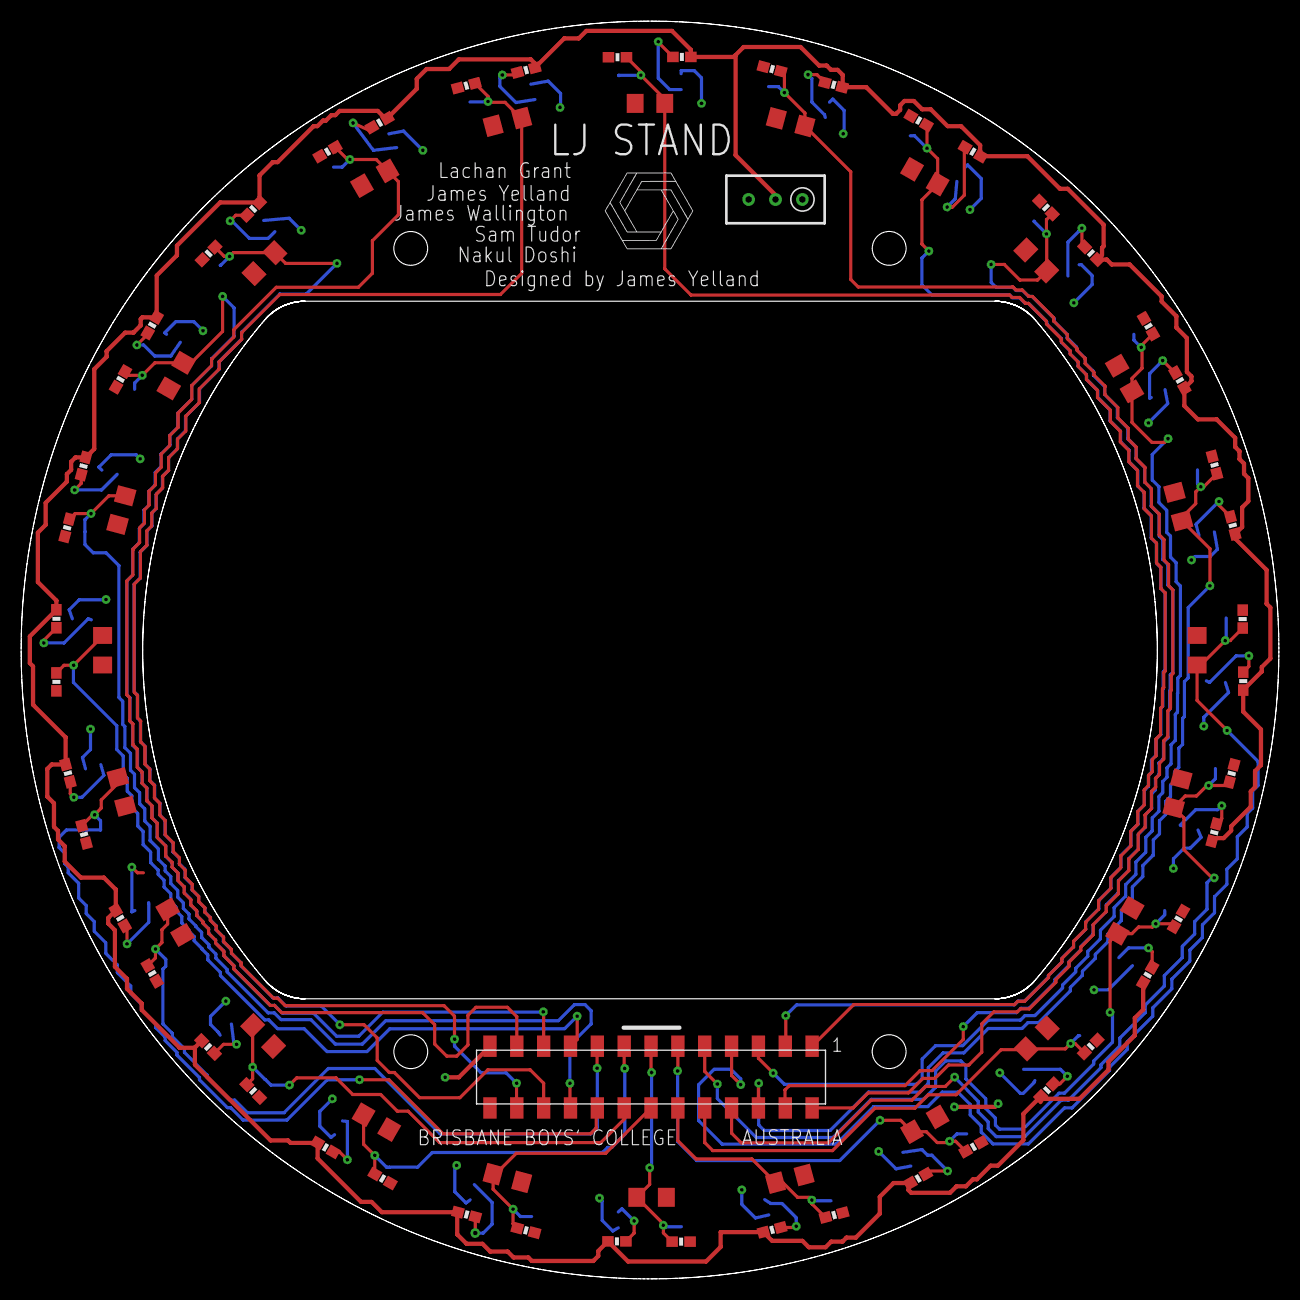
[picture p39: board Light Sensor.brd from above]

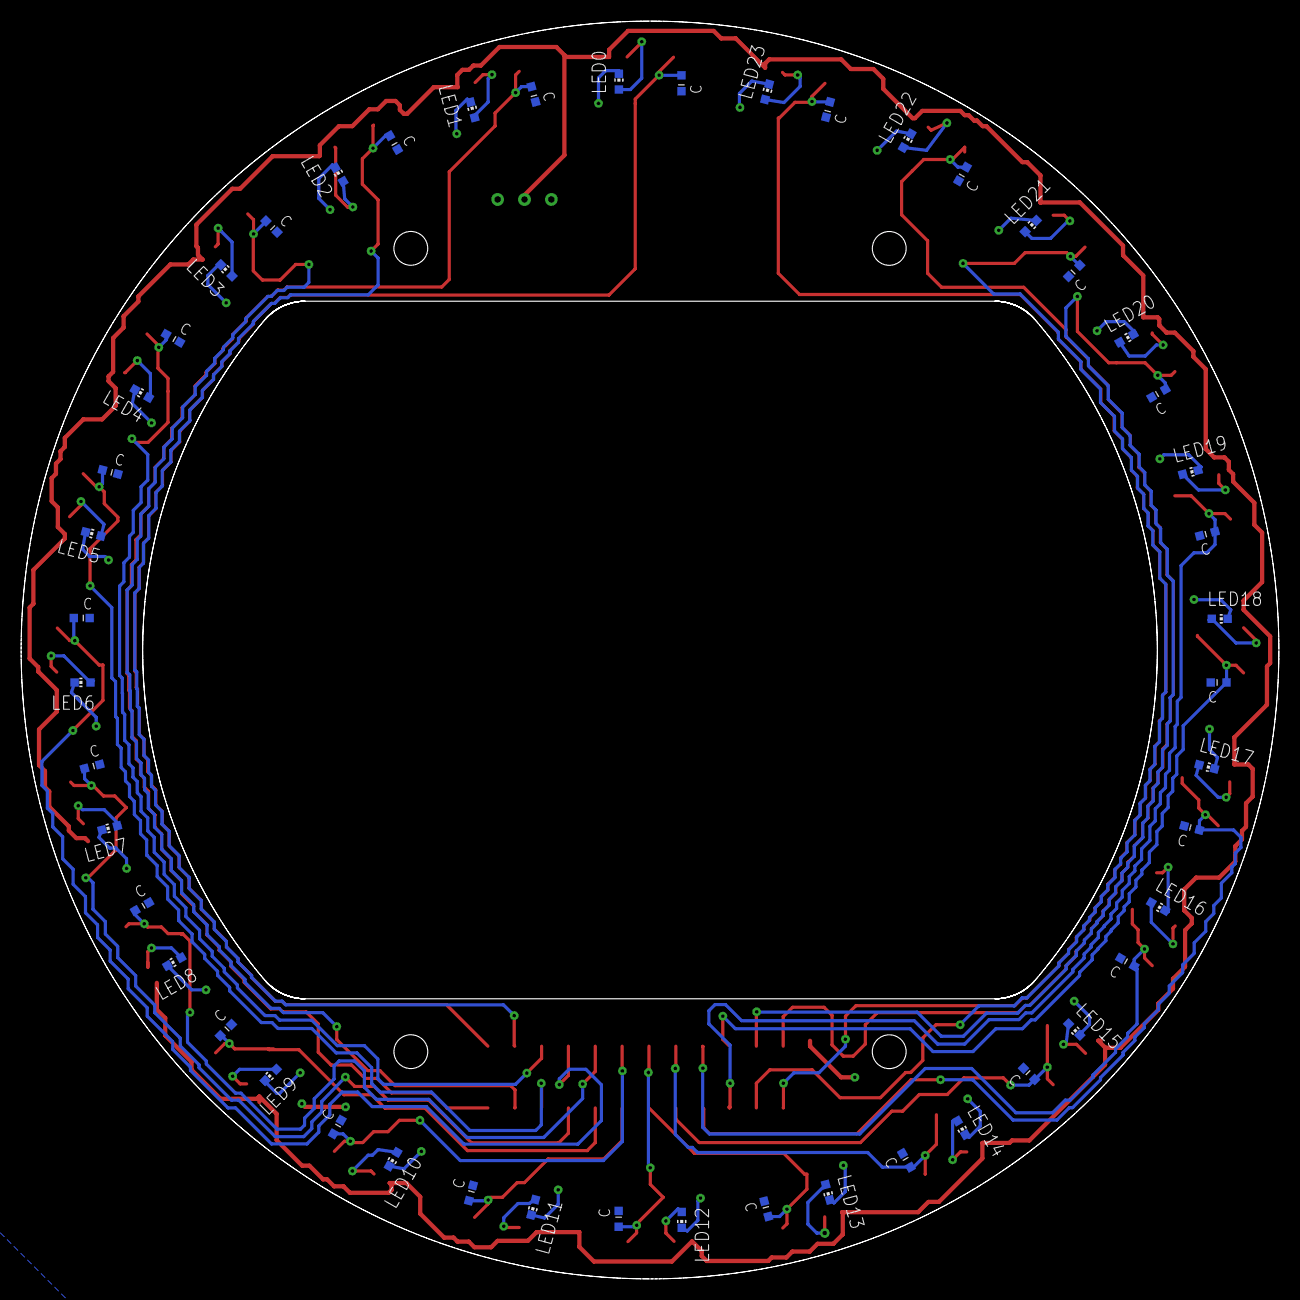
[picture p40: board Light Sensor.brd from below]

Board: 2 copper layers, 119.0 x 119.0 mm, 122 parts (48 on the bottom side), 51 nets.
