LJ-STAND/Design-2017/(commit log)

2016-08-02 Design, has cool middle plate
    [Bottom Plate.0002.ipt, Bottom Plate.ipt, Front Support.ipt, Middle Plate.ipt, Motor Mount Bracket.ipt, Motor Mount Standoff.ipt, Robot.0001.iam, Robot.iam]
2016-08-02 Lots of changes
    [Bottom Plate.0002.ipt, Bottom Plate.0003.ipt, Bottom Plate.ipt, Front Support.0007.ipt, Front Support.ipt, Middle Plate.0012.ipt, Middle Plate.ipt, Motor.ipt]
2016-08-02 Inventor saves
    [Bottom Plate.0003.ipt, Bottom Plate.0004.ipt, Bottom Plate.ipt]
2016-08-09 Removed design, started new one
    [Bottom Plate.ipt, Front Support.ipt, Middle Plate.ipt, PCB.ipt, TSOP Ring.ipt, Top Plate.ipt]
2016-08-09 Bottom & middle plates
    [Bottom Plate.0001.ipt, Bottom Plate.ipt, Middle Plate.0001.ipt, Middle Plate.ipt, Robot.0021.iam, Robot.0022.iam, Robot.iam]
2016-08-09 TSOP Ring
    [Bottom Plate.0001.ipt, Bottom Plate.0003.ipt, Bottom Plate.ipt, Middle Plate.0001.ipt, Middle Plate.0004.ipt, Middle Plate.ipt, Robot.0022.iam, Robot.0036.iam]
2016-08-11 Moved front of robot in
    [Bottom Plate.0003.ipt, Bottom Plate.0004_1.ipt, Bottom Plate.ipt, Middle Plate.0006.ipt, Middle Plate.ipt, TSOP Ring.0002.ipt, TSOP Ring.0003.ipt, TSOP Ring.ipt]
2016-09-20 Lots of things
    [Bottom Plate.0005.ipt, Bottom Plate.0014.ipt, Bottom Plate.ipt, Middle Plate.0011.ipt, Middle Plate.0012.ipt, Middle Plate.0020.ipt, Middle Plate.ipt, Motor Mount Bracket.ipt]
2016-09-21 More stuffs
    [Bottom Plate.0015.ipt, Bottom Plate.0016.ipt, Bottom Plate.ipt, Handle Ring.0002.ipt, Handle Ring.ipt, M12_lens_holder.SLDPRT, M12_lens_holder_D‚faut.ipt, Middle Plate.0021.ipt]
2016-09-24 Lots more things, kicker stuff
    [Bottom Plate.0016.ipt, Bottom Plate.0031.ipt, Bottom Plate.ipt, Kicker Plate.0001.ipt, Kicker Plate.ipt, Laser Diode.ipt, Light Sensor PCB.ipt, Middle Plate.0030.ipt]
2016-09-26 Parts list
    [Parts List.xlsx]
2016-09-26 Parts & EAGLE
    [Main.sch]
2016-09-28 Teensy library
    [Main.brd, Main.sch, Parts List.xlsx]
2016-09-28 Motor controllers
    [Main.brd, Main.sch]
2016-09-28 Lock fixes
    [Main.brd, Main.sch]
2016-10-03 Light sensor PCB
    [Bottom Plate.0009.ipt, Bottom Plate.0010.ipt, Bottom Plate.ipt, Light Sensor.sch, M12_lens_holder_Dfaut.ipt, Pixy(CMUcam5).0002.iam, Pixy(CMUcam5).iam, Robot.0019.iam]
2016-10-10 Logic level converters
    [Main.brd, Main.sch, Middle Plate.0008.ipt, Middle Plate.0013.ipt, Middle Plate.0015.ipt, Middle Plate.ipt, PCB.0012.ipt, PCB.0013.ipt]
2016-10-12 Eagle stuffs
    [Main.brd, Main.sch]
2016-10-13 Combined I2C & SPI buses into one of each
    [Main.brd, Main.sch]
2016-10-13 Tsop array
    [Middle Plate.0015.ipt, Middle Plate.0017.ipt, Middle Plate.ipt, PCB.0014.ipt, PCB.0018.ipt, PCB.ipt, Robot.0023.iam, Robot.0027.iam]
2016-10-13 Light sensor holes
    [Bottom Plate.0010.ipt, Bottom Plate.0011.ipt, Bottom Plate.ipt]
2016-10-14 Top plate
    [Light Sensor PCB.0002.ipt, Light Sensor PCB.ipt, Middle Plate.0017.ipt, Middle Plate.0020.ipt, Middle Plate.ipt, Robot.0028.iam, Robot.0029.iam, Robot.iam]
2016-10-14 Ugly switch holes
    [Handle.0001.ipt, Handle.ipt, Light Sensor PCB.0002.ipt, Light Sensor PCB.0003.ipt, Light Sensor PCB.ipt, PCB.0018.ipt, PCB.0019.ipt, PCB.ipt]
2016-10-14 TSOPS placed on pcb and lots of other stuff
    [M12_lens_holder_D‚faut.ipt, Main.brd, Main.dwg, Main.dxf, Main.sch, PCB.0019.ipt, PCB.0028.ipt, PCB.ipt]
2016-10-14 PCB Routing
    [Main.brd, Main.sch]
2016-10-15 TSOP wires routed. Sanity gone.
    [Main.brd, Main.sch, PCB.0028.ipt, PCB.0029.ipt, PCB.ipt, Robot.0036.iam, Robot.0037.iam, Robot.iam]
2016-10-15 Finished main PCB routing
    [Main.brd, Main.dwg, Main.dxf, Main.sch, PCB.0029.ipt, PCB.0030.ipt, PCB.ipt, Robot.0037.iam]
2016-10-18 Wheels finished
    [5mm 2-56 Screw.0002.ipt, 5mm 2-56 Screw.0003.ipt, 5mm 2-56 Screw.ipt, 8mm M3 Screw.0001.ipt, 8mm M3 Screw.ipt, M3 Nut.ipt, Rod.0001.ipt, Rod.ipt]
2016-10-19 Light PCB
    [Bottom Plate.0017.ipt, Bottom Plate.0020.ipt, Bottom Plate.ipt, Light Sensor PCB.0003.ipt, Light Sensor PCB.0004.ipt, Light Sensor PCB.ipt, Pixy angle bracket.ipt, Robot.0048.iam]
2016-10-20 GND plane spacing
    [Main.brd]
2016-10-25 Added some components to light sensor PCB
    [Robot.0051.iam, Robot.0052.iam, Robot.iam]
2016-10-28 Light sensor connector
    [Light Sensor.sch, Main.sch]
2016-10-28 Trimpot on light pcb
    [Light Sensor.sch]
2016-10-30 Filtering cap on motor controllers
    [Main.sch]
2016-10-30 Standoff material
    [Robot.0052.iam, Robot.0054.iam, Robot.iam, Standoff 10.0015.ipt, Standoff 10.ipt, Standoff 20.0016.ipt, Standoff 20.ipt, Standoff 30.0014.ipt]
2016-10-31 Motor support
    [Bottom Plate.0020.ipt, Bottom Plate.0023.ipt, Bottom Plate.ipt, Motor Mount.0005.ipt, Motor Mount.0007.ipt, Motor Mount.ipt, Motor Support.0003.ipt, Motor Support.ipt]
2016-11-01 Front mount
    [Bottom Plate.0023.ipt, Bottom Plate.0024.ipt, Bottom Plate.ipt, Front mount.0005.ipt, Front mount.ipt, Middle Plate.0026.ipt, Middle Plate.0027.ipt, Middle Plate.ipt]
2016-11-02 Schematic things, removed main board file :/
    [Ball.ipt, Front mount.0005.ipt, Front mount.0009.ipt, Front mount.0010.ipt, Front mount.ipt, Main.brd, Main.sch, Robot.0057.iam]
2016-11-03 LDR hole
    [Front mount.0010.ipt, Front mount.0013.ipt, Front mount.ipt, Robot.0058.iam, Robot.0059.iam, Robot.iam]
2016-11-04 5V Diode
2016-11-05 Finished light sensor schematic
    [Light Sensor.brd]
2016-11-08 DXFs for PCBs
    [Bottom Plate.0024.ipt, Bottom Plate.0025.ipt, Bottom Plate.ipt, Light Sensor PCB.0004.ipt, Light Sensor PCB.0005.ipt, Light Sensor PCB.ipt, Light-2007.dwg, Light.dwg]
2016-11-09 Front mount changes
    [Front mount.0013.ipt, Front mount.0019.ipt, Front mount.ipt, Light Sensor PCB.0005.ipt, Light Sensor PCB.0006.ipt, Light Sensor PCB.ipt, Robot.0059.iam, Robot.0060.iam]
2016-11-09 PCB Image
2016-11-10 DXF files
    [light-eagle.dxf, main - eagle.dxf, main-light.dxf]
2016-11-10 Change ULP Script
    [import-dxf.cfg]
2016-11-10 DXF files - actually this time
    [Light Sensor.brd, Light.dxf, Light2004.dwg, Main.dxf, Main2004.dwg, import-dxf.cfg]
2016-11-11 Removed traces, fixed names - light pcb
    [Light Sensor.brd]
2016-11-11 Redid dimension
    [Light Sensor.brd]
2016-11-11 Some traces on light
    [Light Sensor.brd]
2016-11-11 More traces
    [Light Sensor.brd]
2016-11-11 finished light sensor pcb
    [Light Sensor.brd]
2016-11-11 Light PCB Text
    [Bottom Plate.0028.ipt, Bottom Plate.0029.ipt, Bottom Plate.ipt, Light Sensor PCB.0007.ipt, Light Sensor PCB.0008.ipt, Light Sensor PCB.ipt, Light Sensor.brd, Robot.0065.iam]
2016-11-11 Rebuilt robot assembly using proper fasteners
    [Bottom Plate.0029.ipt, Bottom Plate.ipt, Front mount.0009.ipt, Front mount.0019.ipt, Handle Ring.ipt, Handle.0001.ipt, Handle.ipt, Kicker Plate.ipt]
2016-11-11 Pixy & switches
    [M12_lens_holder_D‚faut.0001.ipt, M12_lens_holder_D‚faut.ipt, Pixy(CMUcam5).0002.iam, Pixy(CMUcam5).iam, Pixy.ipt, Pixy_board_rev1.3.0001.ipt, Pixy_board_rev1.3.ipt, RGB_led_CMS_STD.0001.ipt]
2016-11-12 Logo on light pcb
    [Light Sensor.brd]
2016-11-12 main pcb stuff
    [Main.brd, Robot.0097.iam, Robot.0098.iam, Robot.iam]
2016-11-14 Main pcb
    [Light Sensor.brd, Main.brd, Main.sch, Standoff 10 M-F.0018.ipt, Standoff 10 M-F.ipt]
2016-11-17 Extended front of top plate
    [Middle Plate.0028.ipt, Middle Plate.0029.ipt, Middle Plate.0030.ipt, Middle Plate.0031.ipt, Middle Plate.ipt, Robot.0098.iam, Robot.0101.iam, Robot.iam]
2016-11-22 new top plate
    [Handle.0001.ipt, Handle.0003.ipt, Handle.ipt, LDR Mount.ipt, LDR mount.0022.ipt, LDR mount.0023.ipt, Main PCB.0040.ipt, Main PCB.ipt]
2016-11-24 More main pcb routing
    [Main.brd]
2016-11-24 More routing
    [Main.brd]
2016-11-24 Pcb routing done
    [Main.brd]
2016-11-24 Pin names and drill holes
    [Main.brd]
2016-11-24 PCB design errors
    [Main PCB.0040.ipt, Main PCB.0042.ipt, Main PCB.ipt, Main.brd, Robot.0110.iam, Robot.0111.iam, Robot.iam, Top Plate.0028.ipt]
2016-11-24 bigger motor traces
    [Main.brd]
2016-11-25 Light sensor PCB error fixing
    [Light Sensor.brd, Main.brd, Robot.0111.iam, Robot.0112.iam, Robot.iam]
2016-11-26 Main pcb check against dimensions, made text bigger on both pcbs
    [Light Sensor.brd, Main.brd]
2016-11-26 PCB finalising
    [Main.brd, Main.sch]
2016-11-28 Top plate things
    [Handle.0003.ipt, Handle.0005.ipt, Handle.ipt, Main PCB.0042.ipt, Main PCB.0043.ipt, Main PCB.ipt, Robot.0114.iam, Robot.0119.iam]
2016-11-29 Sonar Mounts
    [Bottom Plate.0030.ipt, Bottom Plate.0032.ipt, Bottom Plate.ipt, Middle Plate.0030.ipt, Middle Plate.0038.ipt, Middle Plate.0041.ipt, Middle Plate.ipt, Motor Mount.0008.ipt]
2016-11-29 Renders & logo
    [Robot.0136.iam, Robot.0138.iam, Robot.iam, Sonar Mount.0006.ipt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]
2016-11-29 Silkscreen changes
2016-11-29 Bigger motor mounts
    [Bottom Plate.0032.ipt, Bottom Plate.0034.ipt, Bottom Plate.ipt, Middle Plate.0041.ipt, Middle Plate.0042.ipt, Middle Plate.0043.ipt, Middle Plate.ipt, Motor Mount.0009.ipt]
2016-11-30 PCB checks
    [Light Sensor.brd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]
2016-11-30 Pcb checking
2016-11-30 Change to 3.3v vreg library
    [Main.sch]
2016-11-30 Fixed 3.3v vreg pins
2016-11-30 more pcb checking
    [Light Sensor.brd]
2016-11-30 Plates and 3D print export
    [Bottom Plate.dwg, Handle.dwg, LDR Mount.stl, Laser Diode Mount.stl, Middle Plate.0042.ipt, Middle Plate.0043.ipt, Middle Plate.0044.ipt, Middle Plate.dwg]
2016-12-01 Design & PCB finalisation
    [Bottom Plate.dwg, Handle.dwg, Light Sensor.brd, Light Sensor.sch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]
2016-12-01 Pcb stuf
    [Robot.0144.iam, Robot.0145.iam, Robot.iam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]
2016-12-03 changed 0805 to 0603 leds
    [Light Sensor.brd, Light Sensor.sch]
2016-12-03 PCB fixing
    [Light Sensor.brd]
2016-12-03 LED Changes
    [Main.sch]
2017-01-31 Larger motor mount holes
    [Bottom Plate.0035.ipt, Bottom Plate.0036.ipt, Bottom Plate.dwg, Bottom Plate.ipt, Middle Plate.0046.ipt, Middle Plate.0048.ipt, Middle Plate.dwg, Middle Plate.ipt]
2017-01-31 Bigger LDR Hole
    [LDR Mount.ipt, LDR Mount.stl, LDR mount.0024.ipt, LDR mount.0026.ipt]
2017-03-07 experimenting with motor angles, eagle files
    [Bottom Plate.dwg]
2017-03-07 Updated EAGLE
    [Main.brd]
2017-03-11 Changed Motor Angles
    [Bottom Plate.0036.ipt, Bottom Plate.0038.ipt, Bottom Plate.0039.ipt, Bottom Plate.ipt, Middle Plate.0048.ipt, Middle Plate.0049.ipt, Middle Plate.0050.ipt, Middle Plate.ipt]
2017-03-12 model and plate exports
    [Bottom Plate.0038.ipt, Bottom Plate.0039_1.ipt, Bottom Plate.dwg, Bottom Plate.ipt, Middle Plate.0049.ipt, Middle Plate.0050_1.ipt, Middle Plate.dwg, Middle Plate.ipt]
2017-03-12 New plate PDFs
    [Bottom Plate.dwg, Middle Plate.dwg, Motor Mount.dwg]
2017-03-12 Removed out of date plate PDFs
2017-03-16 Solenoid circuit
    [Kicker.brd, Kicker.sch, Main.brd, Main.sch]
2017-03-19 Solenoid circuit - added fet & relay and capacitor
    [Kicker.sch]
2017-03-21 Kicker pcb sketch
    [Kicker PCB.0001.ipt, Kicker PCB.ipt, Kicker.dwg, Robot.0149.iam, Robot.0151.iam, Robot.iam]
2017-03-21 Hexagon too small
    [Bottom Plate.dwg, Kicker.brd, Kicker.dxf, Kicker.sch, Kicker2004.dwg]
2017-03-21 hex kicker pcb outline - too small
    [Bottom Plate.0039.ipt, Bottom Plate.0039_1.ipt, Bottom Plate.0040.ipt, Bottom Plate.ipt, Robot.0151.iam, Robot.0152.iam, Robot.iam]
2017-03-23 Kicker pcb - from a few days ago
    [Kicker.brd, Kicker.sch]
2017-03-23 Light sensor cover
    [Light Sensor Cover.dwg, Light Sensor Cover.ipt, Motor Support.stl, Robot.0152.iam, Robot.0153.iam, Robot.iam]
2017-03-23 Light Sensor Cover laser cutting
    [Light Sensor Cover.dwg]
2017-03-27 Fixed small tsop hole
    [TSOP Cover Ring.0018.ipt, TSOP Cover Ring.0019.ipt, TSOP Cover Ring.ipt, TSOP Cover Ring.stl]
2017-03-27 Lowered TSOP ring, dribbler motor block
    [Dribbler block.ipt, Motor sleeve.0001.ipt, Motor sleeve.ipt, Robot.0153.iam, Robot.0154.iam, Robot.iam]
2017-04-06 Kicker PCB -> Dribbler PCB
    [Dribbler.brd, Dribbler.sch, Light Sensor Cover.dwg]
2017-05-18 New motor angles, new light gate plates
    [Battery cover hex.ipt, Battery.0005.ipt, Bottom Plate.0040.ipt, Bottom Plate.0043.ipt, Bottom Plate.ipt, Dribbler Barrel.0001.ipt, Dribbler Barrel.ipt, Dribbler Plate Outer.0007.ipt]
2017-05-19 XBee mount
    [Bottom Plate.0043.ipt, Bottom Plate.0045.ipt, Bottom Plate.ipt, Middle Plate.0054.ipt, Middle Plate.0055.ipt, Middle Plate.ipt, Robot.0157.iam, Robot.0159.iam]
2017-05-19 Smaller light gate mount holes, dwg exports of new plates
    [Bottom Plate.0046.ipt, Bottom Plate.dwg, Bottom Plate.ipt, LDR Mount Plate.0004.ipt, LDR Mount Plate.0005.ipt, LDR Mount Plate.0006.ipt, LDR Mount Plate.dwg, LDR Mount Plate.ipt]
2017-05-29 Top down render
    [Robot.0159.iam, Robot.0160.iam, Robot.iam]
2017-06-24 Back ball capture zone
    [Bottom Plate.0046.ipt, Bottom Plate.0047.ipt, Bottom Plate.ipt, LDR Mount Plate.0005.ipt, LDR Mount Plate.0007.ipt, LDR Mount Plate.ipt, Middle Plate.0056.ipt, Middle Plate.0057.ipt]
2017-06-24 New plate exports
    [Bottom Plate.dwg, LDR Mount Plate.dwg, Middle Plate.dwg]
2017-06-24 OBJ file, top down render
    [Robot.0161.iam, Robot.0162.iam, Robot.iam]
2017-06-24 Removed accidental hole in bottom plate
    [Bottom Plate.0045.ipt, Bottom Plate.0047.ipt, Bottom Plate.0048.ipt, Bottom Plate.dwg, Bottom Plate.ipt, Middle Plate.0057.ipt, Middle Plate.0058.ipt, Middle Plate.dwg]
2017-06-24 STL export
    [LDR Mount.stl, Laser Diode Mount.stl]
2017-06-24 PDF exports
    [Bottom Plate.dwg, LDR Mount Plate.dwg, Middle Plate.dwg]
2017-07-08 Top plate fix, ball capture zone light sensor stuff
    [Ball Capture Zone Cover Plate.0001.ipt, Ball Capture Zone Cover Plate.ipt, Ball capture zone cover.0001.ipt, Ball capture zone cover.0002.ipt, Ball capture zone cover.ipt, Bottom Plate.0048.ipt, Bottom Plate.0055.ipt, Bottom Plate.ipt]
2017-07-10 Final plate and capture zone cover designs, exports
    [Ball Capture Zone Cover.stl, Ball capture zone cover.ipt, Bottom Plate.dwg, Front guard v2.ipt, LDR Mount Plate.dwg, Light sensor ball guard.0001.ipt, Light sensor ball guard.ipt, Middle Plate.dwg]
2017-07-10 Plate PDF's
    [Bottom Plate.dwg, Middle Plate.dwg, Top Plate.dwg]
2017-07-10 AutoCAD save
    [LDR Mount Plate.dwg]
2017-08-10 Tall handle
    [Handle.0005.ipt, Handle.0006.ipt, Handle.ipt, Light Sensor PCB.0010.ipt, Light Sensor PCB.0011.ipt, Light Sensor PCB.ipt, M12_lens_holder_D‚faut.0001.ipt, M12_lens_holder_D‚faut.0002.ipt]
2017-08-10 Tall handle pdf
    [Tall Handle.dwg]
